4111Spyglass/SatNOGS/SatNOGS_Encoder/satnogs-rotator-controller-encoder-bom.xlsx

Sheet: Encoder
Part | Qty To Buy | Qty In project | Sold in Packs of | Unit of Measure | Distributor | Ref | Distributor Ref | Project Section | Price | Cost to Project | Amazon |  |  | McMaster |  |  | AliExpress
Electronic Components, Encoder | 2 | 2 | 1 | PCE | Mouser | C1014-1 |  | Electronics | 3.5 | 7
PCB, Encoder | 5 | 2 | 1 | 5 PCBs | Elecrow | C1014-1 |  | Electronics | 1 | 5
Diametric Magnet NdFeB, Grade N35, D6x2.5mm | 2 | 2 | 1 | PCE | aliexpress | H1050-1 |  | Hardware | 0.2 | 0.4 | https://www.buyneomagnets.com/p/6mm-x-2-5mm-diametrically-magnetized-disc-magnet-neodymium-round-magnets-n35-rare-earth-radial-magnets-100-pack/ | 100 | 15.59
Set Screw M3 L10 DIN 914 | 2 | 2 | 1 | PCE |  | H1090-1 |  | Hardware | 0.2 | 0.4 | rotator
M3 Nut DIN934 | 10 | 10 | 1 | PCE |  | H1070-1 |  | Hardware | 0.03 | 0.3 | rotator
Screw M3L30 DIN965 | 8 | 8 | 1 | PCE |  | H1080-1 |  | Hardware | 0.04 | 0.32 | https://www.amazon.com/uxcell-M3x30mm-Machine-Stainless-Fasteners/dp/B07WCTFG48?pid=89lkzVM&s=industrial | 50 | 8.09
Washer M3 DIN125 | 10 | 10 | 1 | PCE |  | H1070-1 |  | Hardware | 0.03 | 0.3 | rotator
Linear Shaft - D3mm x L50mm cut 2x L25mm, Tolerance: g6 | 1 | 1 | 1 | PCE | aliexpress | H1060-1 |  | Hardware | 1 | 1 | https://www.amazon.com/150mm-Stainless-Industry-Working-Hobbies/dp/B0D5D3XBMK?sp_csd=d2lkZ2V0TmFtZT1zcF9hdGY | 5 | 5.99 | https://www.mcmaster.com/1327K501/ | 1 | 4.2
Deep groove ball bearing 623zz | 4 | 4 | 1 | PCE | ebay | H1040-1 |  | Hardware | 0.2 | 0.8 | https://www.amazon.com/PCS-623ZZ-Ball-Bearings-Applications/dp/B0GH642RYP | 30 | 5.99 |  |  |  | https://www.aliexpress.com/ssr/300000512/BundleDeals2?productIds=1005009361954271%3A12000048960993106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 | 10 | 4.19
Encoder gear 20T, 1.5M, presure angle:20deg, bore 3mm, 3D printed part 0.5mm | 2 | 2 | 1 | PCE |  | C1013-1 |  | Custom Part
Magnet mount | 2 | 2 | 1 | PCE |  | C1012-1 |  | Custom Part
Encoder case lid | 2 | 2 | 1 | PCE |  | C1011-1 |  | Custom Part
Encoder case | 2 | 2 | 1 | PCE |  | C1010-1 |  | Custom Part
 |  |  |  |  |  |  |  |  | Total | 15.52

Sheet: Electronic_Components,_Encoder
Component | Description | Part | References | Value | Footprint | Quantity Per PCB | Datasheet | Mnf. | Price
1 |  | C_Small | C1 | 100n | C_0805_HandSoldering | 1 |  | 08053C104KAT2A | 0.09
2 |  | C_Small | C2 | 1u | C_0805_HandSoldering | 1 |  | CC0805KKX7R7BB105 | 0.085
3 |  | CONN_02X05 | P1 | CONN_02X05 | Pin_Header_Straight_2x05_Pitch2.54mm | 1 |  | Amphenol-861400402YO2LF | 1.18
4 |  | Q_NMOS_GSD | Q1 | Q_NMOS_GSD | SOT-23_Handsoldering | 1 |  | SI2312CDS-T1-GE3 | 0.398
5 |  | R | R1 R2 | 4k7 | R_0805_HandSoldering | 2 |  | CRCW08054K70JNEA | 0.091
6 |  | AS5601-RESCUE-encoder_as5601 | U1 | AS5601 | SOIC-8_3.9x4.9mm_Pitch1.27mm | 1 |  | AS5601-ASOM | 2.78
Component Groups: | 6
Component Count: | 7
Fitted Components: | 7
Num | er of PCBs: | 1
Total components: | 7
Schematic Version:
Schematic Date: | 2018-01-21
BoM Date: | Sun 21 Jan 2018 07:08:43 PM EET
Schematic Source: | /home/azisi/Documents/SatNOGS/satnogs-rotator-controller/satnogs_encoder/encoder_as5601/encoder_as5601.sch
KiCad Version: | Eeschema 4.0.7
