4111Spyglass/SatNOGS/SatNOGS_Rotator/rotator-bom.xlsx

Sheet: DC Motor
Part | Qty To Buy | Qty In project | Sold in Packs of | Unit of Measure | Distributor | Ref | Distributor Ref | Project Section | Price | Cost to Project | Link
Aluminum Tube 6063 OD40 TH1.5 | 2 | 2 | 1 | PCE | Motedis | C1001-1 and C1001-3 | 2287 | Hardware | 0.9 | 1.8 | https://www.motedis.com/shop/Semi-finished-products/Circular-tube-anodized-DIN-6060/Circular-tube-40x15-anodized::1066.html
Shaft Side | 4 | 4 | 1 | PCE |  | C1010-3 |  | Custom Part |  | 0
Shaft Side Bearing Flange | 4 | 4 | 1 | PCE |  | C1011-3 |  | Custom Part |  | 0
Worm Wheel, 30T | 2 | 2 | 1 | PCE |  | C1020-1 |  | Custom Part |  | 0
Shaft Collar ID40 | 2 | 2 | 1 | PCE |  | C1021-1 |  | Custom Part |  | 0
Shaft Washer ID40 OD50 | 2 | 2 | 1 | PCE |  | C1022-1 |  | Custom Part |  | 0
Motor Mount | 2 | 2 | 1 | PCE |  | C1030-1 |  | Custom Part |  | 0
Encoder Gear | 2 | 2 | 1 | PCE |  | C1040-1 |  | Custom Part |  | 0
Homing Pin | 2 | 2 | 1 | PCE |  | C1041-1 |  | Custom Part |  | 0
End-Stop Mount | 2 | 2 | 1 | PCE |  | C1042-1 |  | Custom Part |  | 0
Encoder Mount | 2 | 2 | 1 | PCE |  | C1043-1 |  | Custom Part |  | 0
Aluminum Profil 20x20 B-type slot 6 L100 | 18 | 18 | 1 | PCE | Motedis | C1050-1 | 22206 | Custom Part | 0.3 | 5.4 | https://www.motedis.com/shop/Slot-profiles/Profile-20-B-Type-slot-6/Profile-20x20-B-type-slot-6::1.html
Aluminum Profil 20x20 B-type slot 6 L140 | 8 | 8 | 1 | PCE | Motedis | C1050-5 | 22206 | Custom Part | 0.45 | 3.6 | https://www.motedis.com/shop/Slot-profiles/Profile-20-B-Type-slot-6/Profile-20x20-B-type-slot-6::1.html
Threaded rod M5 DIN975 INOX A2, Worm Gear Shaft | 1 | 1 | 1 | m |  | C1060-1 |  | Hardware | 2.5 | 2.5
Worm Mount | 4 | 4 | 1 | PCE |  | C1061-3 and C1061-4 |  | Custom Part |  | 0
Worm Gear | 2 | 2 | 1 | PCE |  | C1062-1 |  | Custom Part | 10 | 20 | https://www.shapeways.com/
Deep groove ball bearing 625zz | 4 | 4 | 1 | PCE |  | H1011-1 |  | Hardware | 0.6 | 2.4
Deep groove ball bearing 6008zz | 4 | 4 | 1 | PCE |  | H1012-1 |  | Hardware | 4 | 16
Inner bracket B-type Tslot6 | 40 | 40 | 1 | PCE | Motedis | H1020-1 | 099I9006 | Hardware | 0.5 | 20 | https://www.motedis.com/shop/Slot-profile-accessories/Accessories-20-B-Typ-slot-6/Inner-bracket-20-steel-B-Type-slot-6::562.html
T-nut B-type slot 6 M4 | 32 | 32 | 1 | PCE | Motedis | H1021-1 | 096H06410 | Hardware | 0.2 | 6.4 | https://www.motedis.com/shop/Slot-profile-accessories/Accessories-20-B-Typ-slot-6/T-nut-B-type-slot-6-M4::555.html
M5 Nut DIN934 | 4 | 4 | 1 | PCE |  | H1030-1 |  | Hardware | 0.03 | 0.12
M5 Washer DIN125 | 6 | 6 | 1 | PCE |  | H1031-1 |  | Hardware | 0.03 | 0.18
Timing Pulley GT2 36T, bore 5mm, belt wide 6mm | 2 | 2 | 1 | PCE |  | H1040-1 |  | Hardware | 4.2 | 8.4
Timing Belt GT2, Wide 6mm, Length 158mm, Teeth 79 | 2 | 2 | 1 | PCE |  | H1200-1 |  | Hardware | 1.5 | 3
M3 Nut DIN934 | 26 | 26 | 1 | PCE |  | H1070-1 |  | Hardware | 0.03 | 0.78
M4 Nut DIN934 | 24 | 24 | 1 | PCE |  | H1080-1 |  | Hardware | 0.03 | 0.72
Set Screw M3 L10 DIN 914 | 16 | 16 | 1 | PCE |  | H1090-1 |  | Hardware | 0.2 | 3.2
Screw M4 L25 DIN912 | 16 | 16 | 1 | PCE |  | H1100-1 |  | Hardware | 0.05 | 0.8
Screw M4 L20 DIN912 | 8 | 8 | 1 | PCE |  | H1100-3 |  | Hardware | 0.07 | 0.56
Screw M4 L10 DIN912 | 30 | 30 | 1 | PCE |  | H1100-5 |  | Hardware | 0.08 | 2.4
Washer M4 DIN125 | 34 | 34 | 1 | PCE |  | H1110-1 |  | Hardware | 0.03 | 1.02
Screw M3 L10 DIN912 | 8 | 8 | 1 | PCE |  | H1120-1 |  | Hardware | 0.04 | 0.32
Screw M3 L12 DIN912 | 4 | 4 | 1 | PCE |  | H1120-3 |  | Hardware | 0.04 | 0.16
Washer M3 DIN125 | 12 | 12 | 1 | PCE |  | H1130-1 |  | Hardware | 0.03 | 0.36
U Bolts Clamp for 40mm Tube | 4 | 4 | 1 | PCE |  | H1060-1 |  | Hardware | 2 | 8
CAT5e UTP cable | 6 | 6 | 1 | m |  | H1170-5 |  | Electronics | 0.16 | 0.96
End stop switch SS0505 | 2 | 2 | 1 | PCE | HIGHLY | H1050-1 | SS0505A | Electronics | 0.7 | 1.4
Heat-shrinkable, OD 6.4mm for CAT5E cable | 1 | 1 | 1 | m |  | H1160-3 |  | Electronics | 0.3 | 0.3
Heat-shrinkable, OD 4.8mm, for end-stop cables | 1 | 1 | 1 | m |  | H1160-5 |  | Electronics | 0.25 | 0.25
Crimps for Dupont Female 2.54 pitch | 38 | 38 | 1 | PCE | pololu | H1180-1 | 1930 | Electronics | 0.06 | 2.28 | https://www.pololu.com/product/1930
Dupont, Housing Wire Female 4 Pins 2.54mm (2x2P) | 5 | 5 | 1 | PCE | pololu | H1190-1 | 1910 | Electronics | 0.06 | 0.3
Dupont, Housing Wire Female 3 Pins 2.54mm (1x3P) | 6 | 6 | 1 | PCE | pololu | H1190-3 | 1902 | Electronics | 0.04 | 0.24
ABS Filament for FDM 3D-printer | 1 | 1 | 1 | Kg |  | - |  | Hardware | 17 | 17
DC motor adapter | 2 | 2 | 1 | PCE |  | C1070-1 |  | Custom Part |  | 0
DC motor cover part #1 | 2 | 2 | 1 | PCE |  | C1071-1 |  | Custom Part |  | 0
DC motor cover part #2 | 2 | 2 | 1 | PCE |  | C1072-1 |  | Custom Part |  | 0
DC motor, D37mm L54mm, Gear ratio 50:1, 12V 200RPM 1.2Nm | 2 | 2 | 1 | PCE | pololu | H1001-1 | 1104 | Electronics | 25 | 50 | https://www.pololu.com/product/1104
Timing Pulley GT2 20T, bore 6mm, Belt width 6mm | 2 | 2 | 1 | PCE |  | H1041-3 |  | Hardware | 2.6 | 5.2
Screw M3L6 DIN965 | 8 | 8 | 1 | PCE |  | H1140-1 |  | Hardware | 0.04 | 0.32
Capacitor, MLCC - Leaded 0.1uF 50volts X7R 10% 5.0mm L/S | 2 | 2 | 1 | PCE | Mouser | H1150-1 | 75-1C20X7R104K050B | Electronics | 0.15 | 0.3 | https://gr.mouser.com/ProductDetail/Vishay-Sprague/1C20X7R104K050B/
Heat-shrinkable, OD 38.1mm | 1 | 1 | 1 | m |  | H1160-1 |  | Electronics | 1.8 | 1.8
Stranded Cable ~1.5mm^2 (16AWG) – Red | 1 | 1 | 1 | m |  | H1170-1 |  | Electronics | 0.5 | 0.5
Stranded Cable ~1.5mm^2 (16AWG) – Black | 1 | 1 | 1 | m |  | H1170-1 |  | Electronics | 0.5 | 0.5
 |  |  |  |  |  |  |  |  | Total | 188.97

Sheet: Stepper Motor
Part | Qty To Buy | Qty In project | Sold in Packs of | Unit of Measure | Distributor | Ref | Distributor Ref | Project Section | Price | Cost to Project | Link
Aluminum Tube 6063 OD40 TH1.5 | 2 | 2 | 1 | PCE | Motedis | C1001-1 and C1001-3 | 2287 | Hardware | 0.9 | 1.8 | https://www.motedis.com/shop/Semi-finished-products/Circular-tube-anodized-DIN-6060/Circular-tube-40x15-anodized::1066.html
Shaft Side | 4 | 4 | 1 | PCE |  | C1010-3 |  | Custom Part |  | 0
Shaft Side Bearing Flange | 4 | 4 | 1 | PCE |  | C1011-3 |  | Custom Part |  | 0
Worm Wheel, 30T | 2 | 2 | 1 | PCE |  | C1020-1 |  | Custom Part |  | 0
Shaft Collar ID40 | 2 | 2 | 1 | PCE |  | C1021-1 |  | Custom Part |  | 0
Shaft Washer ID40 OD50 | 2 | 2 | 1 | PCE |  | C1022-1 |  | Custom Part |  | 0
Motor Mount | 2 | 2 | 1 | PCE |  | C1030-1 |  | Custom Part |  | 0
Encoder Gear | 2 | 2 | 1 | PCE |  | C1040-1 |  | Custom Part |  | 0
Homing Pin | 2 | 2 | 1 | PCE |  | C1041-1 |  | Custom Part |  | 0
End-Stop Mount | 2 | 2 | 1 | PCE |  | C1042-1 |  | Custom Part |  | 0
Encoder Mount | 2 | 2 | 1 | PCE |  | C1043-1 |  | Custom Part |  | 0
Aluminum Profil 20x20 B-type slot 6 L100 | 18 | 18 | 1 | PCE | Motedis | C1050-1 | 22206 | Custom Part | 0.3 | 5.4 | https://www.motedis.com/shop/Slot-profiles/Profile-20-B-Type-slot-6/Profile-20x20-B-type-slot-6::1.html
Aluminum Profil 20x20 B-type slot 6 L140 | 8 | 8 | 1 | PCE | Motedis | C1050-5 | 22206 | Custom Part | 0.45 | 3.6 | https://www.motedis.com/shop/Slot-profiles/Profile-20-B-Type-slot-6/Profile-20x20-B-type-slot-6::1.html
Threaded rod M5 DIN975 INOX A2, Worm Gear Shaft | 1 | 1 | 1 | m |  | C1060-1 |  | Hardware | 2.5 | 2.5
Worm Mount | 4 | 4 | 1 | PCE |  | C1061-3 and C1061-4 |  | Custom Part |  | 0
Worm Gear | 2 | 2 | 1 | PCE |  | C1062-1 |  | Custom Part | 10 | 20 | https://www.shapeways.com/
Deep groove ball bearing 625zz | 4 | 4 | 1 | PCE |  | H1011-1 |  | Hardware | 0.6 | 2.4
Deep groove ball bearing 6008zz | 4 | 4 | 1 | PCE |  | H1012-1 |  | Hardware | 4 | 16
Inner bracket B-type Tslot6 | 40 | 40 | 1 | PCE | Motedis | H1020-1 | 099I9006 | Hardware | 0.5 | 20 | https://www.motedis.com/shop/Slot-profile-accessories/Accessories-20-B-Typ-slot-6/Inner-bracket-20-steel-B-Type-slot-6::562.html
T-nut B-type slot 6 M4 | 32 | 32 | 1 | PCE | Motedis | H1021-1 | 096H06410 | Hardware | 0.2 | 6.4 | https://www.motedis.com/shop/Slot-profile-accessories/Accessories-20-B-Typ-slot-6/T-nut-B-type-slot-6-M4::555.html
M5 Nut DIN934 | 4 | 4 | 1 | PCE |  | H1030-1 |  | Hardware | 0.03 | 0.12
M5 Washer DIN125 | 6 | 6 | 1 | PCE |  | H1031-1 |  | Hardware | 0.03 | 0.18
Timing Pulley GT2 36T, bore 5mm, belt wide 6mm | 2 | 2 | 1 | PCE |  | H1040-1 |  | Hardware | 4.2 | 8.4
Timing Belt GT2, Wide 6mm, Length 158mm, Teeth 79 | 2 | 2 | 1 | PCE |  | H1200-1 |  | Hardware | 1.5 | 3
M3 Nut DIN934 | 26 | 26 | 1 | PCE |  | H1070-1 |  | Hardware | 0.03 | 0.78
M4 Nut DIN934 | 24 | 24 | 1 | PCE |  | H1080-1 |  | Hardware | 0.03 | 0.72
Set Screw M3 L10 DIN 914 | 16 | 16 | 1 | PCE |  | H1090-1 |  | Hardware | 0.2 | 3.2
Screw M4 L25 DIN912 | 16 | 16 | 1 | PCE |  | H1100-1 |  | Hardware | 0.05 | 0.8
Screw M4 L20 DIN912 | 8 | 8 | 1 | PCE |  | H1100-3 |  | Hardware | 0.07 | 0.56
Screw M4 L10 DIN912 | 30 | 30 | 1 | PCE |  | H1100-5 |  | Hardware | 0.08 | 2.4
Washer M4 DIN125 | 34 | 34 | 1 | PCE |  | H1110-1 |  | Hardware | 0.03 | 1.02
Screw M3 L10 DIN912 | 8 | 8 | 1 | PCE |  | H1120-1 |  | Hardware | 0.04 | 0.32
Screw M3 L12 DIN912 | 4 | 4 | 1 | PCE |  | H1120-3 |  | Hardware | 0.04 | 0.16
Washer M3 DIN125 | 12 | 12 | 1 | PCE |  | H1130-1 |  | Hardware | 0.03 | 0.36
U Bolts Clamp for 40mm Tube | 4 | 4 | 1 | PCE |  | H1060-1 |  | Hardware | 2 | 8
CAT5e UTP cable | 6 | 6 | 1 | m |  | H1170-5 |  | Electronics | 0.16 | 0.96
End stop switch SS0505 | 2 | 2 | 1 | PCE | HIGHLY | H1050-1 | SS0505A | Electronics | 0.7 | 1.4
Heat-shrinkable, OD 6.4mm for CAT5E cable | 1 | 1 | 1 | m |  | H1160-3 |  | Electronics | 0.3 | 0.3
Heat-shrinkable, OD 4.8mm, for end-stop cables | 1 | 1 | 1 | m |  | H1160-5 |  | Electronics | 0.25 | 0.25
Crimps for Dupont Female 2.54 pitch | 38 | 38 | 1 | PCE | pololu | H1180-1 | 1930 | Electronics | 0.06 | 2.28 | https://www.pololu.com/product/1930
Dupont, Housing Wire Female 4 Pins 2.54mm (2x2P) | 5 | 5 | 1 | PCE | pololu | H1190-1 | 1910 | Electronics | 0.06 | 0.3
Dupont, Housing Wire Female 3 Pins 2.54mm (1x3P) | 6 | 6 | 1 | PCE | pololu | H1190-3 | 1902 | Electronics | 0.04 | 0.24
ABS Filament for FDM 3D-printer | 1 | 1 | 1 | Kg |  | - |  | Hardware | 17 | 17
Stepper motor NEMA17, L47mm, 1.8deg step angle, D-shaft 5mm, Max torque 0.48Nm, without cables | 2 | 2 | 1 | PCE | GRobotronics | H1003-1 | 14-00010849 | Hardware | 16 | 32 | https://grobotronics.com/stepper-motor-42byghw804.html
Timing Pulley GT2 20T, bore 5mm, Belt width 6mm | 2 | 2 | 1 | PCE |  | H1041-1 |  | Hardware | 2.6 | 5.2
Cables 4P for Stepper Motor 70cm JST PH 6P-DUPONT | 2 | 2 | 1 | PCE | GRobotronics | H1170-3 | 19-00010760 | Electronics | 1.2 | 2.4 | https://grobotronics.com/wire-4p-for-stepper-motor-70cm-jst-ph-6p-dupont.html
 |  |  |  |  |  |  |  |  | Total | 170.45
