4111Spyglass/SatNOGS/SatNOGS_Rotator/part-number-list.xlsx

Sheet: Hardware
Part Number | Description | Comments | QTY | Checked | In Stock | Amazon | Units | Cost | McMaster | Units | Cost | AliExpress | Units | Cost
H1001-1_dc_motor | DC motor, D37mm L54mm, Gear ratio 50:1 | DC motor D-Shaft | 2
H1003-1_stepper_motor_nema17 | Stepper motor NEMA17 | This stepper comes with D-Shaft and JST PH male connector on body of motor | 2
H1011-1_625zz | Deep groove ball bearing 625zz | Worm gear axis | 4 | x |  | https://www.amazon.com/uxcell-Groove-Bearings-Shielded-Bearing/dp/B0CJFSBRTJ | 15 | 6.29 | https://www.mcmaster.com/6153K15/ | 1 | 11.57 | https://www.aliexpress.us/item/3256808307376732.html?curPageLogUid=nbfa5K8uiVS3 | 10 | 5.54
H1012-1_6008zz | Deep groove ball bearing 6008zz | Worm wheel axis | 4 | x |  | https://www.amazon.com/ACROPIX-Bearings-40x68x15mm-Lubricated-Skateboard/dp/B0DJ8GDG85 | 4 | 14.77
H1020-1_Inner_bracket_btype_tslot6 | Inner bracket B-type Tslot6 |  | 44 | x |  | https://www.amazon.com/gp/product/B0C6JNRMCV?smid=A1QO26FH6S25Z4&th=1 (https://www.amazon.com/30Sets-Inner-Connector-Extrusion-Brackets/dp/B0C19GVBXB) | 24 | 6.99 |  |  |  | https://www.aliexpress.com/ssr/300000512/BundleDeals2?productIds=1005007087913831%3A12000039358031725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 | 20 | 5.39
H1021-1_bType_nut 6_M4 | B-Typ Nut 6/M4 |  | 32 | x |  | https://www.amazon.com/DGZZI-Nickel-Plated-Aluminum-Extrusion-Fastener/dp/B0C5HWS6F8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 | 100 | 6.99 |  |  |  | https://www.aliexpress.us/item/3256807197032414.html?curPageLogUid=qujSwJRj8fUM | 100 | 6.73
H1030-1_nut_M5_din934 | Nut M5 DIN934 | Worm gear axis | 4 | x |  | https://www.amazon.com/Juvielich-100pcs-Stainless-Fasteners-Replacement/dp/B0D1X2YBLJ | 100 | 5.49 | https://www.mcmaster.com/90592A095/ | 100 | 2.89
H1031-1_washer_M5_din125 | Washer M5 DIN125 | Worm gear axis | 6 | x |  | https://www.amazon.com/Washer-Stainless-Steel-Washers-100PCS/dp/B0BGHBH8RM?sp_csd=d2lkZ2V0TmFtZT1zcF9hdGY | 100 | 4.99 | https://www.mcmaster.com/98687A110/ | 100 | 2.75
H1040-1_pulley_gt2_36T | Timing Pulley GT2 36T, bore 5mm, belt width 6mm | Worm gear axis | 2 | x |  | https://www.amazon.com/Yeebyee-Pulleys-Synchronous-Aluminum-Printers/dp/B0F8ZY24R5?nsdOptOutParam=true | 4 | 12.99 |  |  |  | https://www.aliexpress.us/item/3256806064924677.html?curPageLogUid=9SVPr5AjrKA3 | 1 | 2.23
H1041-1_pulley_gt2_20T | Timing Pulley GT2 20T, bore 5mm, belt width 6mm | Stepper motor axis | 2 |  |  | https://www.amazon.com/SHCEEC-Timing-Pulleys-Printer-Aluminum/dp/B0CB13VP52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 | 5 | 6.49 |  |  |  | https://www.aliexpress.us/item/3256806064924677.html?curPageLogUid=9SVPr5AjrKA3 | 1 | 1.43
H1041-3_pulley_gt2_20T | Timing Pulley GT2 20T, bore 6mm, belt width 6mm | DC motor axis | 2
H1050-1_switch_SS0505 | End stop switch SS0505 |  | 2 | x |  | https://www.amazon.com/dp/B07X142VGC?sp_csd=d2lkZ2V0TmFtZT1zcF9ocXBfc2hhcmVk | 10 | 5.99
H1060-1 | U Bolts Clamp | The model not exist in shared file | 4
H1070-1_nut_M3_din934 | Nut M3 DIN934 |  | 26 | x | x | https://www.amazon.com/dp/B0D99ZJ832?ref_=ppx_hzsearch_conn_dt_b_fed_asin_title_2&th=1 | 100 | 5.97 | https://www.mcmaster.com/90592A085/ | 100 | 1.43
H1080-1_nut_M4_din934 | Nut M4 DIN934 |  | 24 | x | x | https://www.amazon.com/dp/B0D99YP7BP?ref_=ppx_hzsearch_conn_dt_b_fed_asin_title_2&th=1 | 200 | 6.58 | https://www.mcmaster.com/90592A090/ | 100 | 2.09
H1090-1_set_screw_M3L10_din914 | Set Screw M3 L10 DIN914 |  | 16 | x |  | https://www.amazon.com/Internal-Socket-Screws-Stainless-Steel/dp/B0CZ6WYF2T?s=industrial | 100 | 5.99 | https://www.mcmaster.com/91390A103/ | 100 | 13.66
H1100-1_screw_M4L25_din912 | Socket head screw M4 L25 DIN912 |  | 16 | x |  | https://www.amazon.com/BNUOK-120pcs-Socket-Threads-Spanner/dp/B0DYSCWBPR?pid=CidL1Pd&s=industrial | 125 | 8,54 | https://www.mcmaster.com/91290A176/ | 50 | 10.41
H1100-3_screw_M4L20_din912 | Socket head screw M4 L20 DIN912 |  | 8 | x |  | https://www.amazon.com/dp/B0DYSQZHC9/ref=dp_iou_view_item?ie=UTF8&th=1 | 120 | 8.09 | https://www.mcmaster.com/91274A121/ | 50 | 6.11
H1100-5_screw_M4L10_din912 | Socket head screw M4 L10 DIN912 |  | 30 | x |  | https://www.amazon.com/dp/B0DYSDQ6TV/ref=dp_iou_view_item?ie=UTF8&th=1 | 120 | 7.19 | https://www.mcmaster.com/91274A117/ | 50 | 5.28
H1110-1_washer_M4_din125 | Washer M4 DIN125 |  | 34 | x | x | https://www.amazon.com/Washer-Stainless-Steel-Washers-100PCS/dp/B0BGH6YLB7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 | 100 | 4.99 | https://www.mcmaster.com/98687A134/ | 100 | 2.97
H1120-1_screw_M3L10_din912 | Socket head screw M3 L10 DIN912 | For motor mount | 8 |  |  | https://www.amazon.com/Moicstiy-Socket-Screws-Machine-Finish/dp/B0D5B61YVS?s=industrial (https://www.amazon.com/BNUOK-180pcs-Socket-Threads-Spanner/dp/B0DJQGKM9L?pid=r94gVAq&s=industrial) | 100 | 4.49 | https://www.mcmaster.com/91274A105/ | 50 | 5.43
H1120-3_screw_M3L12_din912 | Socket head screw M3 L12 DIN912 | For end-stop | 4 | x |  | https://www.amazon.com/Moicstiy-Socket-Screws-Machine-Finish/dp/B0D5B4SL18?s=industrial (https://www.amazon.com/BNUOK-180pcs-Socket-Threads-Spanner/dp/B0DJQGKM9L?pid=r94gVAq&s=industrial) | 100 | 4.49 | https://www.mcmaster.com/91274A106/ | 50 | 5.42
H1130-1_washer_M3_din125 | Washer M3 DIN125 |  | 12 | x | x | https://www.amazon.com/LIZIFEQZ-100Pcs-Stainless-Washers-Screws/dp/B0GV85XBNG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 | 100 | 4.49 | https://www.mcmaster.com/98687A133/ | 100 | 1.83
H1140-1_screw_M3L6_din965 | Phillips Flat Head Screw M3 L6 DIN965 | For DC motor flange | 8
H1150-1 | MLCC - Leaded 0.1uF 50volts X7R 10% 5.0mm L/S, for DC motors | mouser, model not exist in shared file (http://gr.mouser.com/ProductDetail/Vishay-Sprague/1C20X7R104K050B/) | 2
H1160-1 | Heat-shrinkable, OD 38.1mm, for DC motor wheather shielding | The part is assembled with C1071-1 and C1072-1 (per 1m), model not exist in shared file | 1
H1160-3 | Heat-shrinkable, OD 6.4mm for CAT5E cable | Per 1m, model not exist in shared file | 1
H1160-5 | Heat-shrinkable, OD 4.8mm, for cables, end stop | Per 1m, model not exist in shared file | 1
H1170-1 | Cables for DC motors, ~1.5mm^2 (16AWG) | Per 1m Black and per 1m Red, model not exist in shared file | 2
H1170-3 | Cables 4P for Stepper Motor 70cm (JST PH 6P-DUPONT) | The model not exist in shared file | 2
H1170-5 | CAT5e UTP cable for endstop, encoder, sensors and rotator cable | Per 1m, model not exist in shared file | 6
H1180-1 | Crimps for Dupont Female, 2.54mm pitch | The model not exist in shared file | 38
H1190-1 | Dupont, Housing Wire Female 4 Pins 2.54mm (2x2P) | The model not exist in shared file | 5
H1190-3 | Dupont, Housing Wire Female 3 Pins 2.54mm (1x3P) | The model not exist in shared file | 6
H1200-1 | Timing Belt GT2, Wide 6mm, Length 158mm, Teeth 79 | The model not exist in shared file | 1 |  |  | https://www.amazon.com/MECCANIXITY-Timing-Printing-Closed-Rubber/dp/B0FRDQ7K8F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 | 5 | 7.19 |  |  |  | https://www.aliexpress.us/item/3256807338029262.html?curPageLogUid=nvgNUC7FGfGE | 1 | 1.51
H1210-1 | Phillips Rounded Head Screws for Sheet Metal, M3,5 X 6,5 | The model not exist in shared file | 12
H1220-1 | Slotted pin DIN1481, OD4 Χ L60, 0.14E PCE
C1001-1_symmetric_tube | Aluminium tube OD40mm TH1.5mm L240mm |  |  |  |  | https://www.amazon.com/dp/B0C6QT439J?niid=nl_cl_lst_a_2_1&nrid=VE7B784SGHV6MM5EAPV9 | 2*300 | 12.89
C1001-3_asymmetric_tube | Aluminium tube OD40mm TH1.5mm L320mm |  |  |  |  | https://www.amazon.com/dp/B0F9D8VPC9?niid=nl_cl_lst_a_1_2&nrid=VE7B784SGHV6MM5EAPV9 | 400mm | 17.89 |  |  |  |  |  |  | https://www.harfington.com/products/p-1465918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 | 400 | 14.34

Sheet: Parts
Part Number | Description | Comments | QTY | Check | Sheet
C1001-1_symmetric_tube | Aluminium tube OD40mm TH1.5mm L240mm | Drawing: convert to 1.5"? | 1 | x | A1030
C1001-3_asymmetric_tube | Aluminium tube OD40mm TH1.5mm L320mm | Drawing: convert to 1.5"? | 1
C1010-1_shaft_side | Shaft deep groove ball bearing 6008zz mount | Layer height 0.4mm | 4
C1010-3 | Updated version of shaft side | Layer height 0.4mm | 4 | x | A1031-1 | A1032-1
C1011-1_shaft_bearing | Shaft deep groove ball bearing 6008zz mount | Layer height 0.4mm | 4 | x | A1031-1
C1011-3 | Updated version of shaft side | Layer height 0.4mm | 4 | x | A1032-1
C1020-1_shaft_gear | Worm wheel gear, 30T | Layer height 0.4mm | 2 | x | A1030
C1021-1_shaft_collar | Worm wheel mount | Layer height 0.4mm, metric/imperial option | 2 | x | A1020-1
C1022-1_shaft_spacer | Spacer or washer for shaft | Layer height 0.4mm, metric/imperial option | 2
C1022-3 | Updated version of shaft washer | Layer height 0.4mm or laser cuted | 2 | x | A1030
C1030-1_motor_mount | Motor mount | Layer height 0.4mm | 2 | x | A1070-1
C1040-1_encoder_gear | Encoder gear, slot to mount homing pin | Layer height 0.4mm, metric/imperial option | 2 | x | A1033-1
C1041-1_homing_pin | Homing pin | Layer height 0.4mm, metric/imperial option | 2 | x | A1033-1
C1042-1_endstop_mount | End stop mount | Layer height 0.4mm | 2 | x | A1032-1
C1043-1_encoder_mount | Encoder mount | Layer height 0.4mm | 2 | x | A1032-1
C1050-1_tslot6_100 | Aluprofil 20x20 B-Typ Nut 6 L100 | Drawing | 18 | x | A1001-3
~~C1050-3_tslot6_160~~ | ~~Aluprofil 20x20 B-Typ Nut 6 L160~~ | ~~-~~ | ~~8~~
C1050-5 | Updated version of C1050-3, L140 | - | 8 | x | A1001-3 | A1040
C1060-1_worm_shaft | Threaded rod M5 L100 for worm gear shaft | Drawing | 2 | x | A1010-1
C1061-1_worm_mount | Worm mount | Layer height 0.4mm | 2
C1061-2_worm_mount | worm mount mirror part | Layer height 0.4mm | 2
C1061-3 | Updated version of C1061-1 | Layer height 0.4mm | 2 | x | A1011
C1061-4 | Updated version of C1061-2 | Layer height 0.4mm | 2 | x | A1011
C1062-1_worm_gear | Worm gear, is laser sintering part with nylon plastic | Laser sintering part, shapeways | 2 | x | A1010-1
C1070-1_dc_motor_adapter | DC motor flange to mount in common stepper motor mount | Layer height 0.4mm | 2
C1071-1_dc_motor_cover | DC motor cover, part 1 | Layer height 0.4mm | 2
C1072-1_dc_motor_cover | DC motor cover, part 2 | Layer height 0.4mm | 2
C1080-1_cover_bottom | Cover box, bottom part | Sheet metal working, Drawing | 1
C1081-1_cover_top | Cover box, top part | Sheet metal working, Drawing | 1
C1082-1_cover_side | Cover box, side part | Sheet metal working, Drawing | 1
C1082-3_cover_side | Cover box, side part | Sheet metal working, Drawing | 1
C1082-5 | Cover box, side part, new revision of C1082-1 and -3 | Sheet metal working, Drawing | 2
C1083-1_shaft_seal | Shaft seal | Layer height 0.4mm, metric/imperial option | 3

Sheet: Assemblies
Part Number | Description | Comments | QTY | Checked | Sheet
A1001-1_frame | Frame chassis sub assembly | Drawing | - | x | A1001-3 | A1030
A1001-3_frame | Frame chassis sub assembly | Drawing | 2 | x | A1040
A1010-1_worm_gear | Worm gear assembly | Drawing | 2 | x | A1040
A1011-1_worm_mount | Worm mount assembly | Drawing | 2 | x | A1001-3
A1011-2_worm_mount | Worm mount assembly, mirror | - | 2
A1020-1_shaft_collar | Shaft collar assembly for worm wheel | Drawing | 2 | x | A1030
A1030-1_rotator_axis | Rotator axis assembly without frame, symmetric | Drawing | 2 | x | A1040
A1030-3_rotator_axis | Rotator axis assembly without frame, asymmetric | - | 2
A1031-1_bearing_side | Bearing side assembly without end-stop and encoder mounts | Drawing | 2 | x | A1030
A1032-1_bearing_side | Bearing side assembly with end-stop and encoder mounts | Drawing | 2 | x | A1030
A1033-1_encoder_gear | Encoder gear assembly | Drawing | 2 | x | A1030
A1040-1_symmetric_module | Rotator axis module with frame, symmetric | Drawing | 2 | x | A1050-1
A1040-3_assymetric_module | Rotator axis module with frame, asymmetric | - | 2 | x | A1050-1
A1050-1_az_el_rotator | Alt-Az antenna rotator | Drawing | 1
A1060-1_dc_motor | DC motor assembly | Drawing | 2 | x | A1030
A1070-1_motor_mount | Motor Mount assembly | Drawing | 2
