4111Spyglass/SatNOGS/SatNOGS_Controller/lsf-kicad-lib-master/3d/MQ_Sensors/MQ-131.step

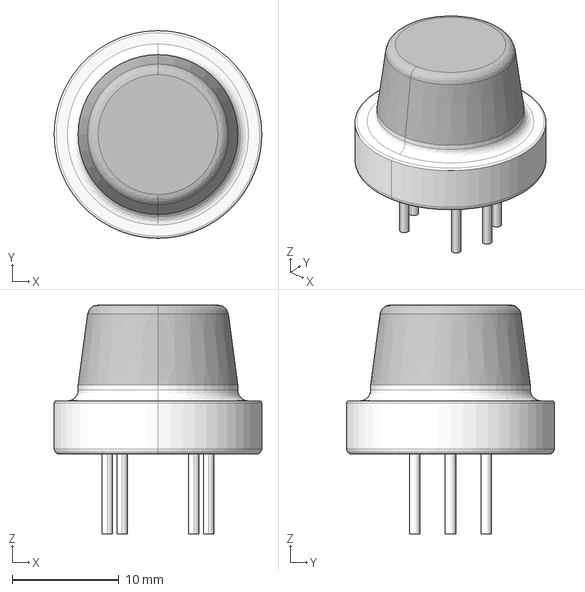
[picture p1: CAD file, 2026-06-04]
SatNOGS_Controller/lsf-kicad-lib-master/3d/MQ_Sensors/MQ-131.step
19.5 x 19.5 x 21.5 mm
