4111Spyglass/SatNOGS/SatNOGS_Controller/lsf-kicad-lib-master/3d_sources/D2F-L2-A1.FCStd

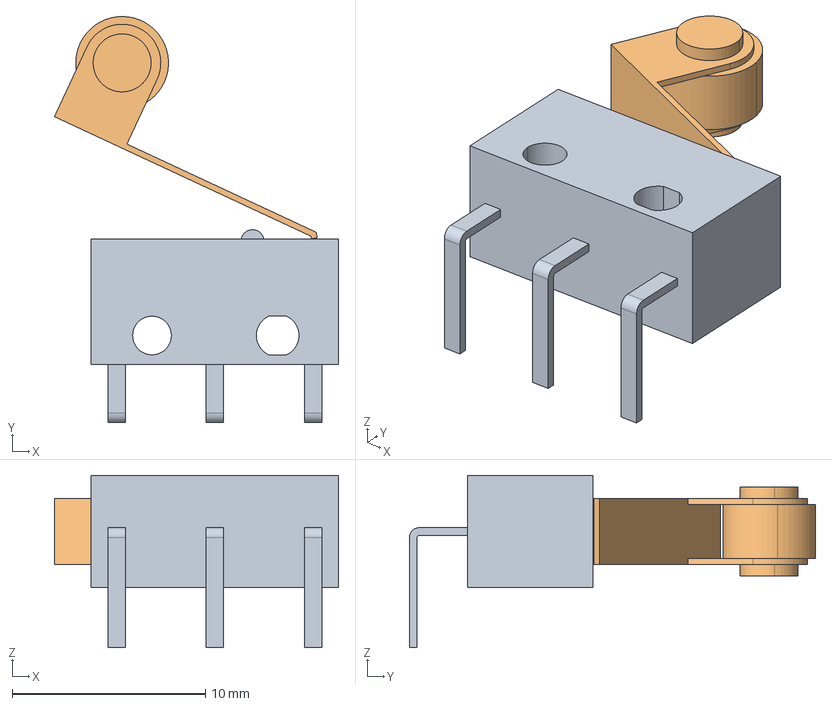
[picture p2: CAD file, 2026-06-04]
SatNOGS_Controller/lsf-kicad-lib-master/3d_sources/D2F-L2-A1.FCStd
14.7 x 21.0 x 8.90 mm
D2F_L2_A1_BASE
D2F_L2_A1_ACTUATOR
