4111Spyglass/SatNOGS/SatNOGS_Controller/SatNOGS_Controller.step

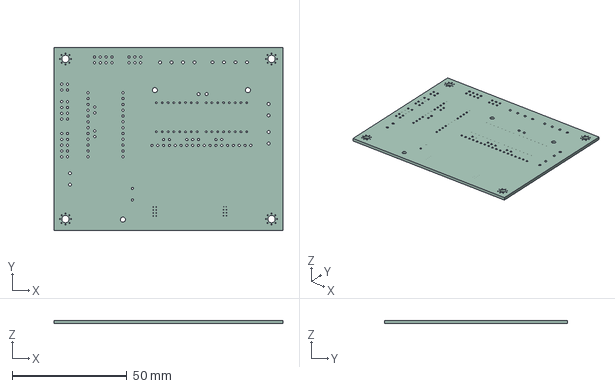
[picture p3: CAD file, 2026-06-04]
SatNOGS_Controller/SatNOGS_Controller.step
100.0 x 80.0 x 1.51 mm
