4111Spyglass/SatNOGS/SatNOGS_Controller/step/drv8825-stepper-motor-driver-carrier-high-current.step

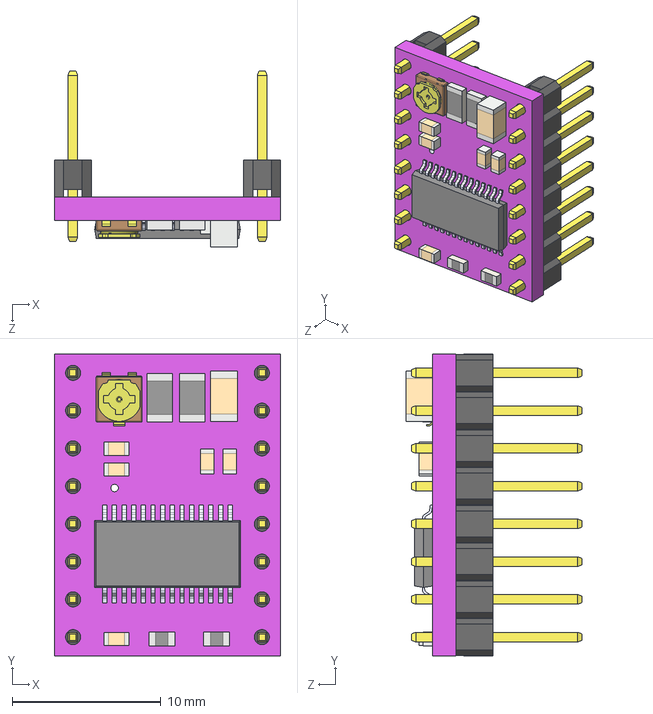
[picture p4: CAD file, 2026-06-04]
SatNOGS_Controller/step/drv8825-stepper-motor-driver-carrier-high-current.step
15.2 x 20.3 x 11.9 mm
