4111Spyglass/SatNOGS/SatNOGS_Encoder/encoder_parts/C1012-1_magnet_mount.fcstd

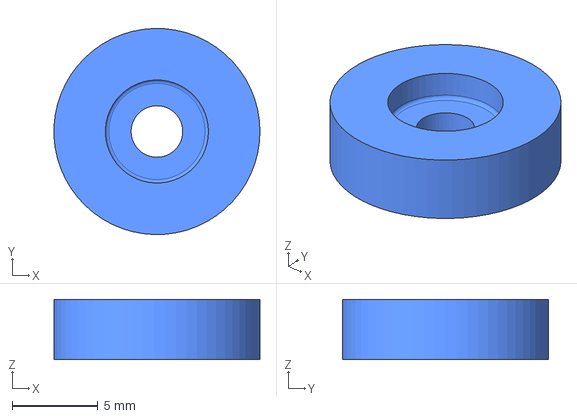
[picture p5: CAD file, 2026-06-04]
SatNOGS_Encoder/encoder_parts/C1012-1_magnet_mount.fcstd
12.0 x 12.0 x 3.50 mm
