4111Spyglass/SatNOGS/SatNOGS_Rotator/rotator_parts/C1070-1_dc_motor_adapter.fcstd

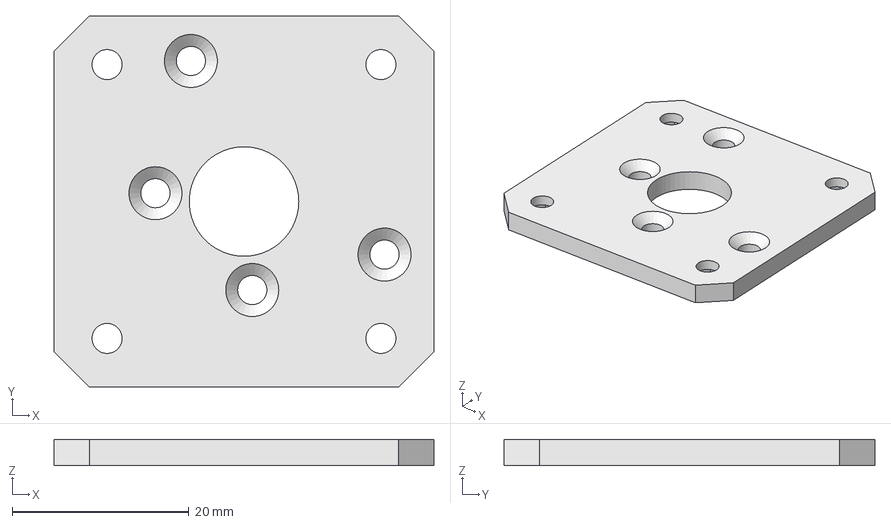
[picture p6: CAD file, 2026-06-04]
SatNOGS_Rotator/rotator_parts/C1070-1_dc_motor_adapter.fcstd
43.0 x 42.0 x 3.00 mm
