4111Spyglass/SatNOGS/SatNOGS_Encoder/encoder_parts/C1013-1_encoder_gear-Body.3mf

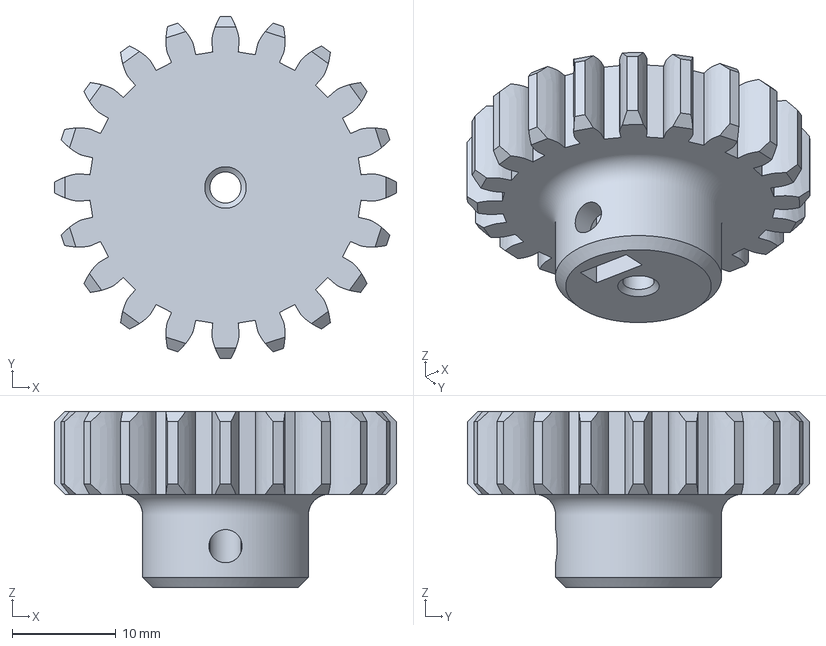
[picture p7: CAD file, 2026-06-04]
SatNOGS_Encoder/encoder_parts/C1013-1_encoder_gear-Body.3mf
33.0 x 33.0 x 17.0 mm
