4111Spyglass/SatNOGS/SatNOGS_Rotator/rotator_parts/C1010-3.fcstd

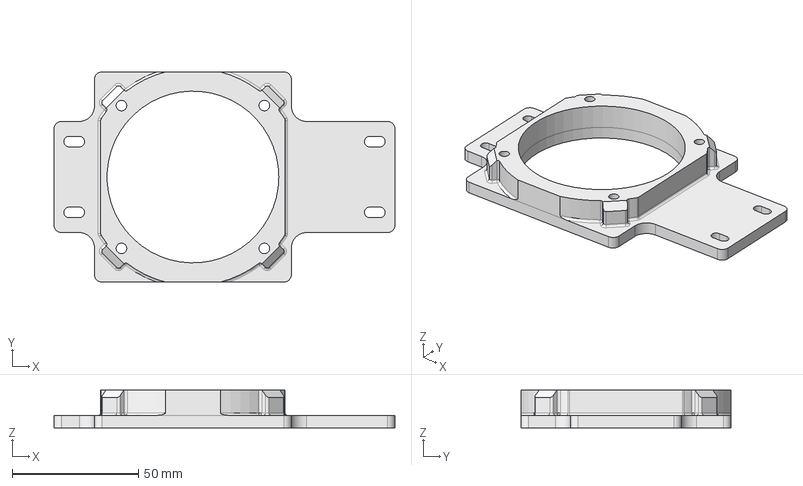
[picture p8: CAD file, 2026-06-04]
SatNOGS_Rotator/rotator_parts/C1010-3.fcstd
135.0 x 83.2 x 15.0 mm
