4111Spyglass/SatNOGS/SatNOGS_Controller/lsf-kicad-lib-master/3d_sources/SMC_Amphenol_152119_Vertical.FCStd

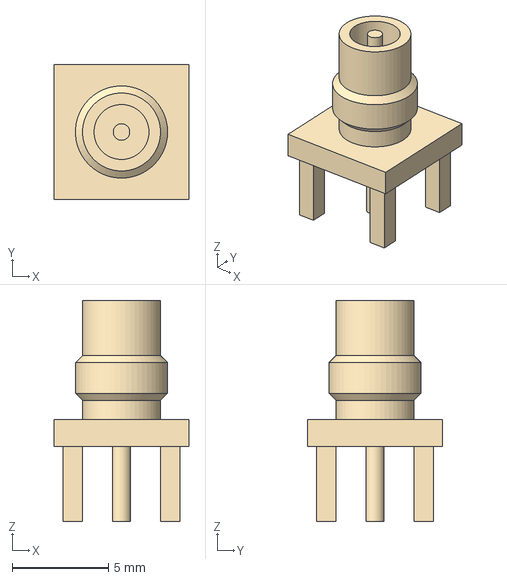
[picture p9: CAD file, 2026-06-04]
SatNOGS_Controller/lsf-kicad-lib-master/3d_sources/SMC_Amphenol_152119_Vertical.FCStd
7.00 x 7.00 x 11.5 mm
