4111Spyglass/SatNOGS/SatNOGS_Encoder/encoder_parts/C1011-1_encoder_case.fcstd

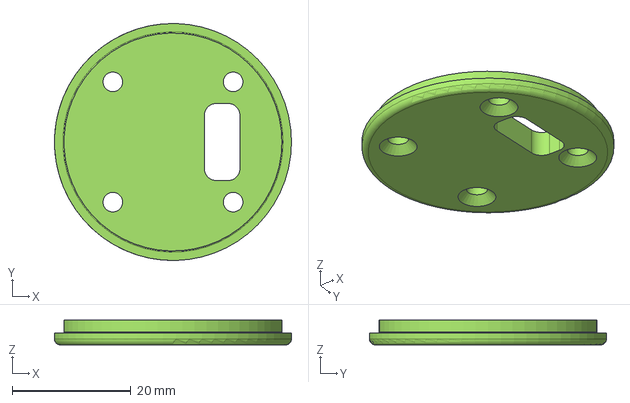
[picture p10: CAD file, 2026-06-04]
SatNOGS_Encoder/encoder_parts/C1011-1_encoder_case.fcstd
40.0 x 40.0 x 4.20 mm
