4111Spyglass/SatNOGS/SatNOGS_Rotator/rotator_parts/C1042-1_endstop_mount.fcstd

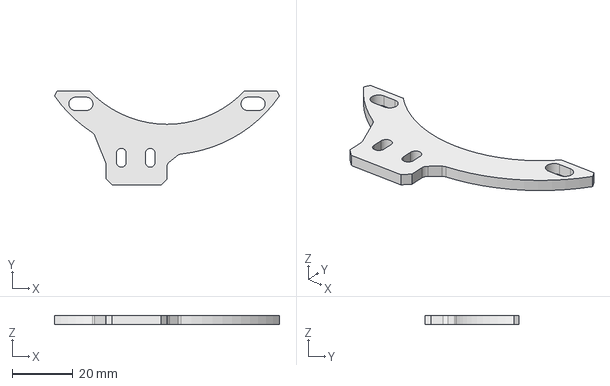
[picture p11: CAD file, 2026-06-04]
SatNOGS_Rotator/rotator_parts/C1042-1_endstop_mount.fcstd
73.9 x 31.0 x 3.00 mm
