4111Spyglass/SatNOGS/SatNOGS_Encoder/encoder_parts/C1010-1_encoder_case.fcstd

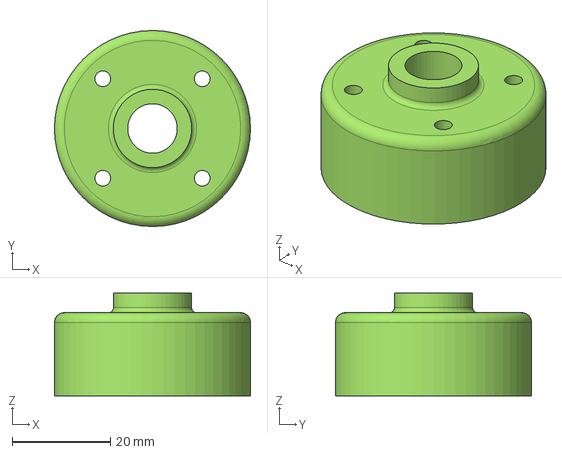
[picture p12: CAD file, 2026-06-04]
SatNOGS_Encoder/encoder_parts/C1010-1_encoder_case.fcstd
40.0 x 40.0 x 21.0 mm
