4111Spyglass/SatNOGS/SatNOGS_Rotator/rotator_parts/C1050-1_tslot6_100.fcstd

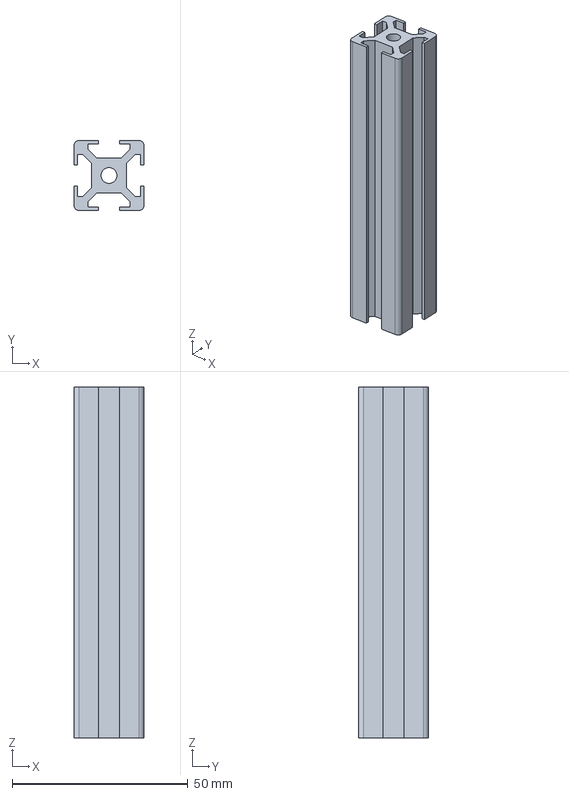
[picture p13: CAD file, 2026-06-04]
SatNOGS_Rotator/rotator_parts/C1050-1_tslot6_100.fcstd
20.0 x 20.0 x 100.0 mm
