4111Spyglass/SatNOGS/SatNOGS_Controller/lsf-kicad-lib-master/3d_sources/MQ-7.FCStd

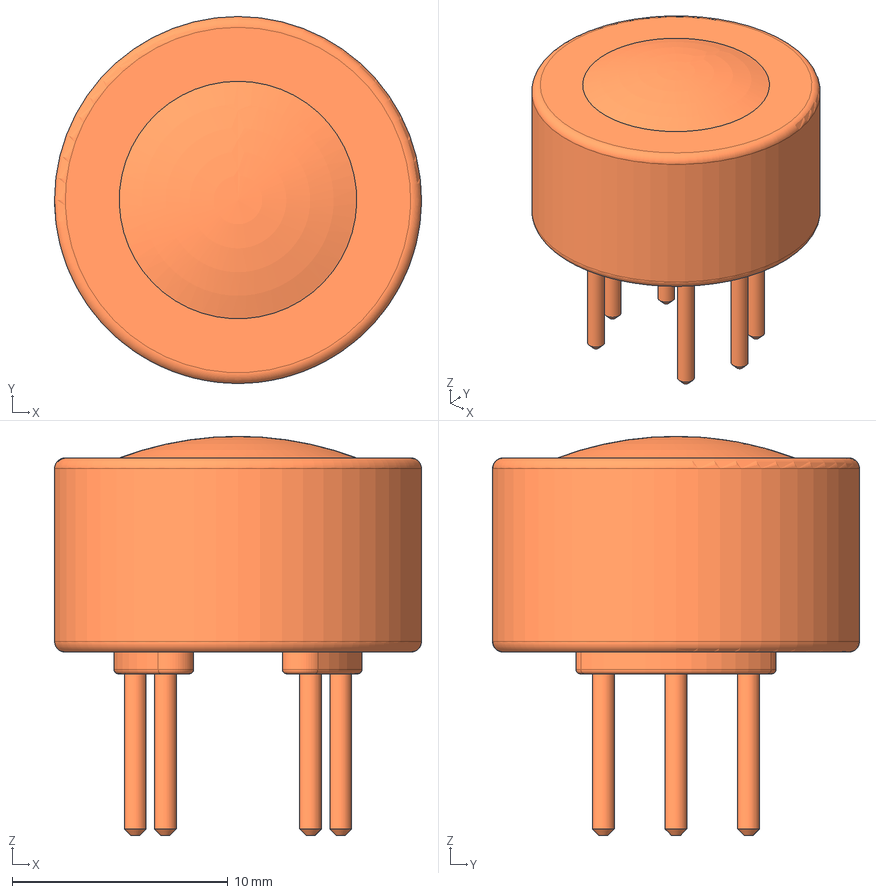
[picture p14: CAD file, 2026-06-04]
SatNOGS_Controller/lsf-kicad-lib-master/3d_sources/MQ-7.FCStd
17.0 x 17.0 x 18.5 mm
