4111Spyglass/SatNOGS/SatNOGS_Encoder/encoder_parts/A1010-1_as5601_encoder.fcstd

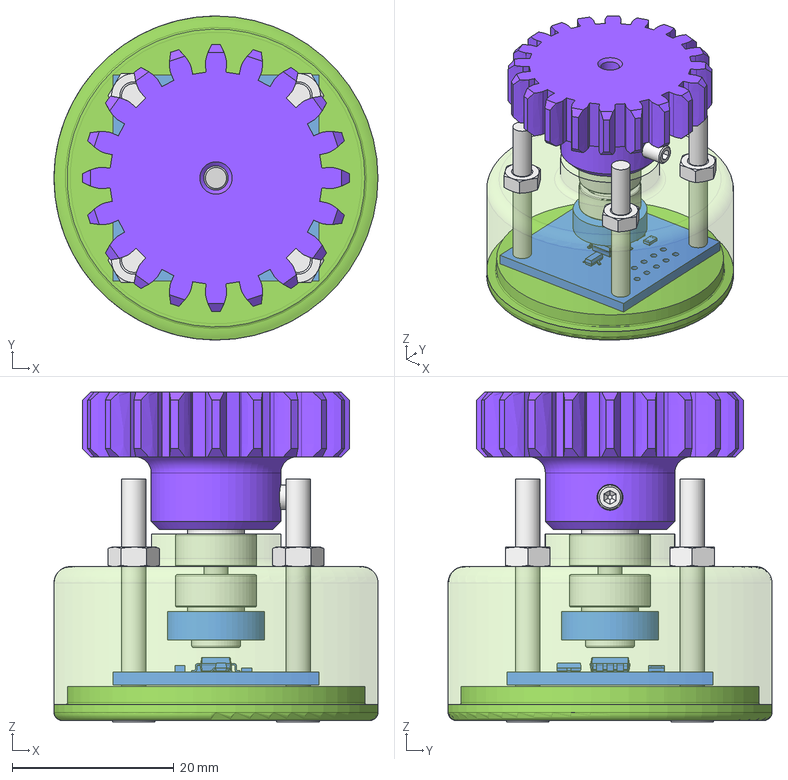
[picture p15: CAD file, 2026-06-04]
SatNOGS_Encoder/encoder_parts/A1010-1_as5601_encoder.fcstd
40.0 x 40.0 x 40.7 mm
H1010_623zz_01
H1010_623zz_02
H1090_washer_M3_din125_01
C1093_magnet_mount_01
H1070_diametric_magnet_01
H1110_encoder_shaft_01
H1090_washer_M3_din125_02
C1091_encoder_case_01
C1096_encoder_gear_01
H1020_1_nut_M3_din934_01
H1080_1_screw_M3L30_din965_01
H1080_1_screw_M3L30_din965_02
H1080_1_screw_M3L30_din965_03
H1080_1_screw_M3L30_din965_04
H1020_1_nut_M3_din934_01001
H1020_1_nut_M3_din934_02
H1020_1_nut_M3_din934_03
H1020_1_nut_M3_din934_04
C1014_1_pcb_as5601_01
C1010_1_encoder_case_01
H1090_1_set_screw_M3L10_din914_01
