4111Spyglass/SatNOGS/SatNOGS_Rotator/rotator_parts/C1082-3_cover_side.fcstd

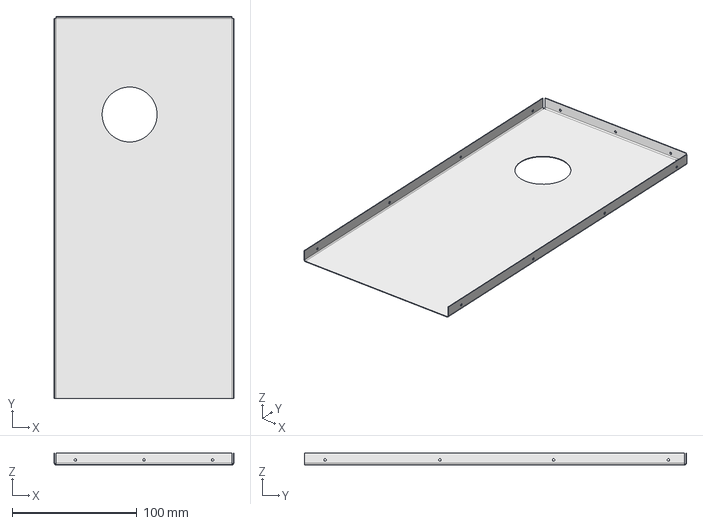
[picture p16: CAD file, 2026-06-04]
SatNOGS_Rotator/rotator_parts/C1082-3_cover_side.fcstd
144.0 x 306.0 x 9.50 mm
