4111Spyglass/SatNOGS/SatNOGS_Controller/lsf-kicad-lib-master/3d_sources/SM141K04LV.FCStd

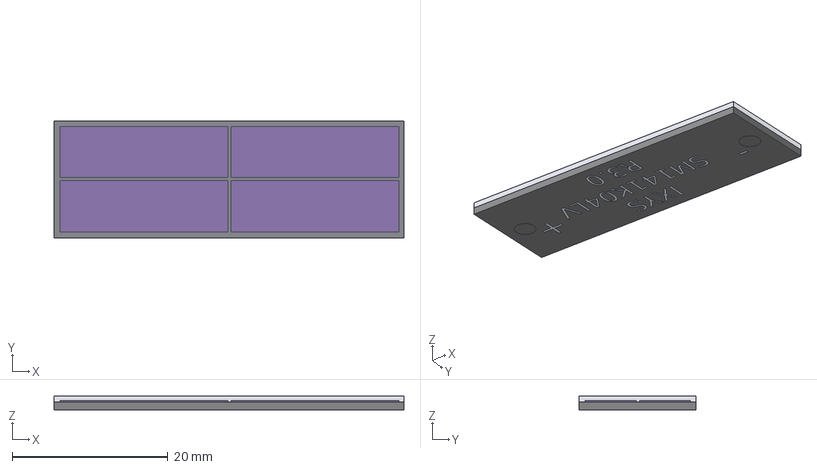
[picture p17: CAD file, 2026-06-04]
SatNOGS_Controller/lsf-kicad-lib-master/3d_sources/SM141K04LV.FCStd
45.0 x 15.0 x 1.81 mm
SM141K04LV
cell1
cell2
cell3
cell4
IXYS
SM141K04LV001
R3.0
+
