4111Spyglass/SatNOGS/SatNOGS_Encoder/encoder_parts/C1014-1_pcb_as5601.fcstd

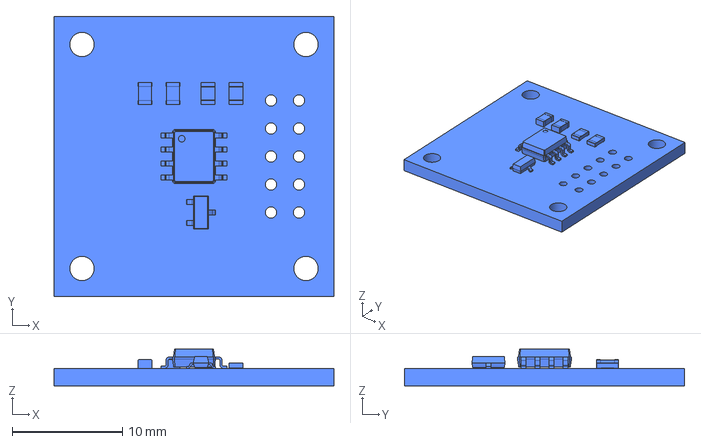
[picture p18: CAD file, 2026-06-04]
SatNOGS_Encoder/encoder_parts/C1014-1_pcb_as5601.fcstd
25.4 x 25.4 x 3.35 mm
