4111Spyglass/SatNOGS/SatNOGS_Rotator/rotator_parts/C1022-3.fcstd

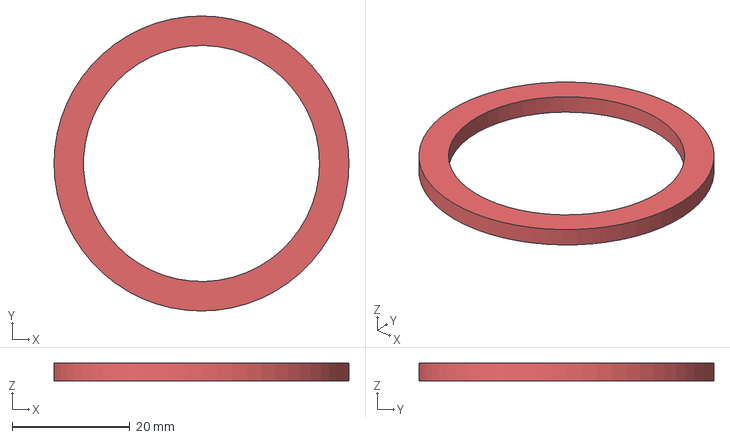
[picture p19: CAD file, 2026-06-04]
SatNOGS_Rotator/rotator_parts/C1022-3.fcstd
50.0 x 50.0 x 3.00 mm
