4111Spyglass/SatNOGS/SatNOGS_Controller/lsf-kicad-lib-master/3d_sources/SW_SPST_SPVN110107.FCStd

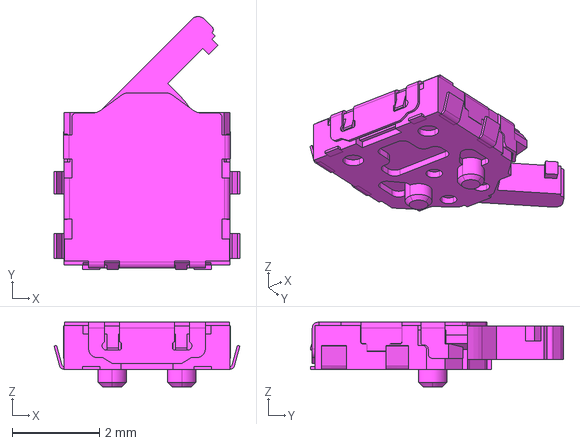
[picture p20: CAD file, 2026-06-04]
SatNOGS_Controller/lsf-kicad-lib-master/3d_sources/SW_SPST_SPVN110107.FCStd
4.26 x 5.80 x 1.48 mm
