4111Spyglass/SatNOGS/SatNOGS_Rotator/rotator_parts/C1011-3.fcstd

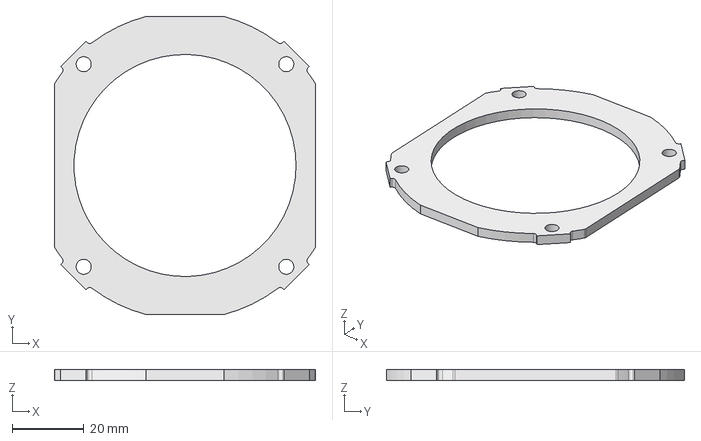
[picture p21: CAD file, 2026-06-04]
SatNOGS_Rotator/rotator_parts/C1011-3.fcstd
73.0 x 83.2 x 3.00 mm
