4111Spyglass/SatNOGS/SatNOGS_Controller/lsf-kicad-lib-master/3d_sources/SATA-3M-5607-5102-SH.FCStd

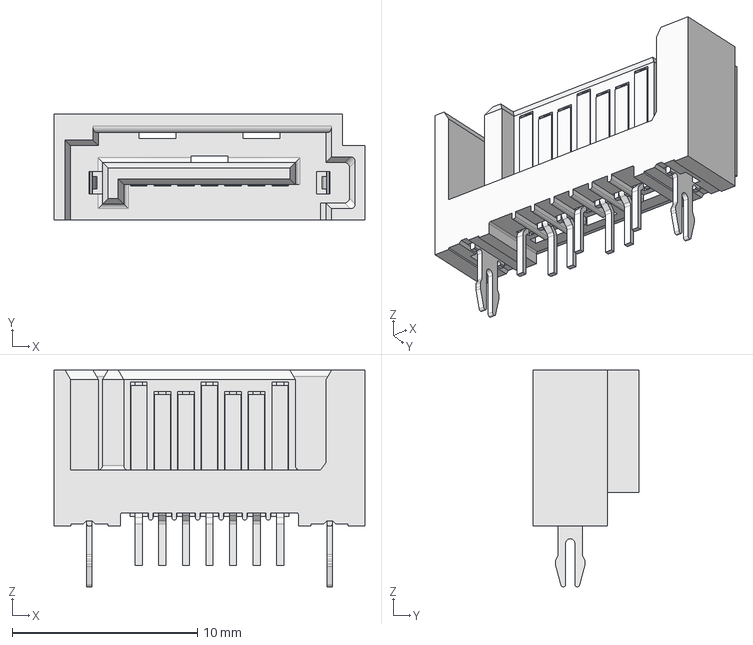
[picture p22: CAD file, 2026-06-04]
SatNOGS_Controller/lsf-kicad-lib-master/3d_sources/SATA-3M-5607-5102-SH.FCStd
16.8 x 5.70 x 11.7 mm
