4111Spyglass/SatNOGS/SatNOGS_Rotator/rotator_parts/C1020-1_shaft_gear.fcstd

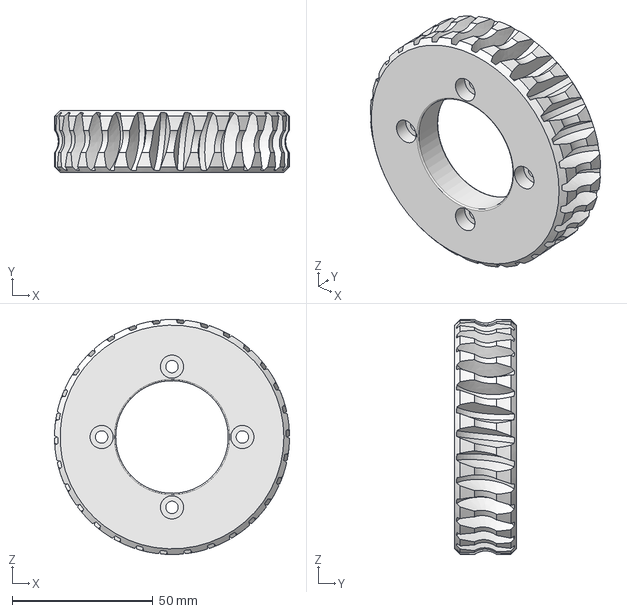
[picture p23: CAD file, 2026-06-04]
SatNOGS_Rotator/rotator_parts/C1020-1_shaft_gear.fcstd
83.5 x 22.0 x 83.5 mm
