4111Spyglass/SatNOGS/SatNOGS_Rotator/rotator_parts/C1001-3_asymmetric_tube.fcstd

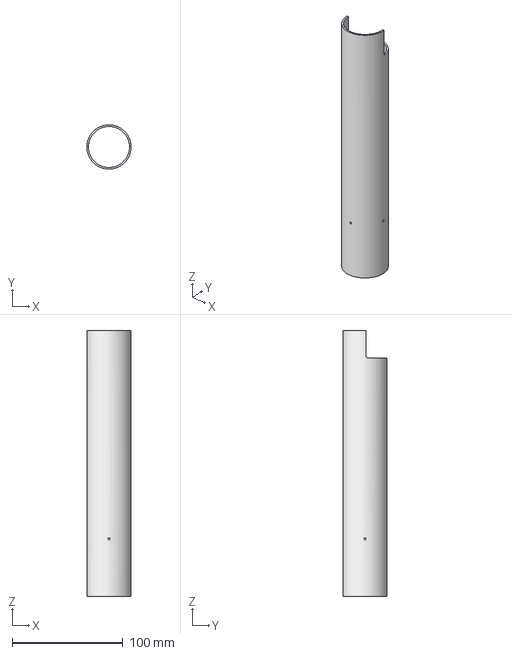
[picture p24: CAD file, 2026-06-04]
SatNOGS_Rotator/rotator_parts/C1001-3_asymmetric_tube.fcstd
40.0 x 40.0 x 240.0 mm
