4111Spyglass/SatNOGS/SatNOGS_Controller/lsf-kicad-lib-master/3d_sources/DF11-10DP-2DS.FCStd

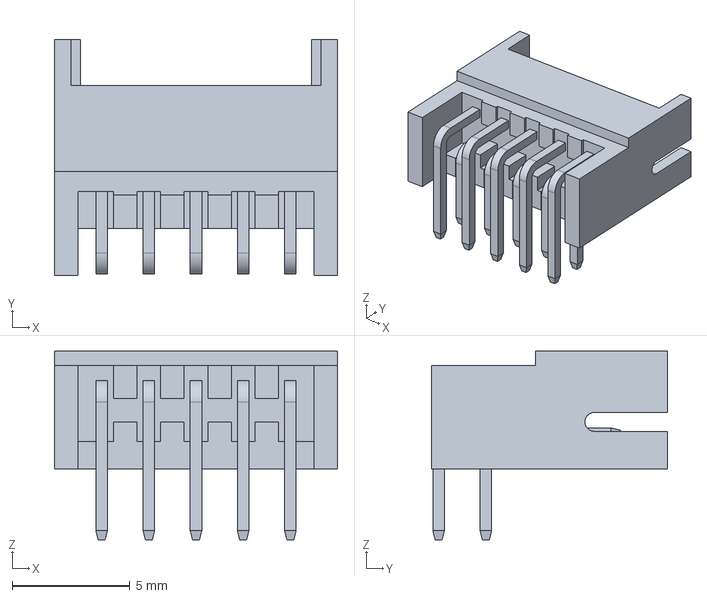
[picture p25: CAD file, 2026-06-04]
SatNOGS_Controller/lsf-kicad-lib-master/3d_sources/DF11-10DP-2DS.FCStd
12.0 x 10.0 x 8.00 mm
