4111Spyglass/SatNOGS/SatNOGS_Rotator/rotator_parts/C1081-1_cover_top.fcstd

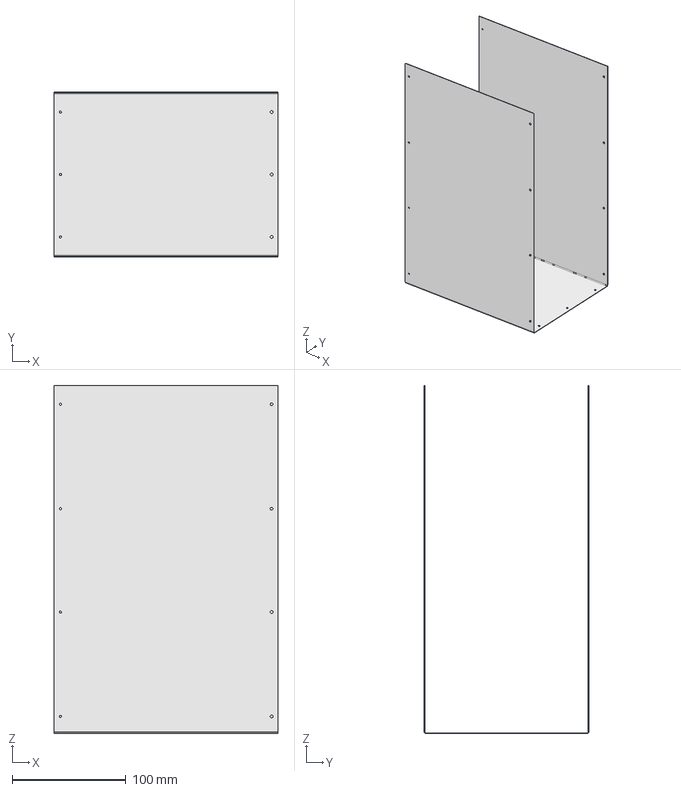
[picture p26: CAD file, 2026-06-04]
SatNOGS_Rotator/rotator_parts/C1081-1_cover_top.fcstd
197.0 x 145.0 x 306.5 mm
