4111Spyglass/SatNOGS/SatNOGS_Controller/lsf-kicad-lib-master/3d_sources/D2F-L.FCStd

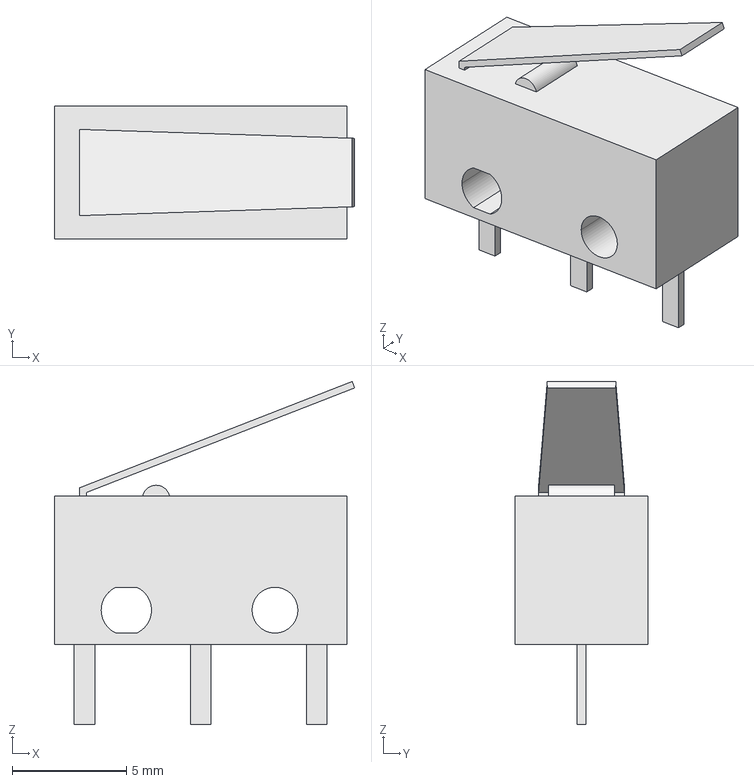
[picture p27: CAD file, 2026-06-04]
SatNOGS_Controller/lsf-kicad-lib-master/3d_sources/D2F-L.FCStd
13.1 x 5.80 x 15.0 mm
