4111Spyglass/SatNOGS/SatNOGS_Rotator/rotator_parts/C1040-1_encoder_gear.3mf

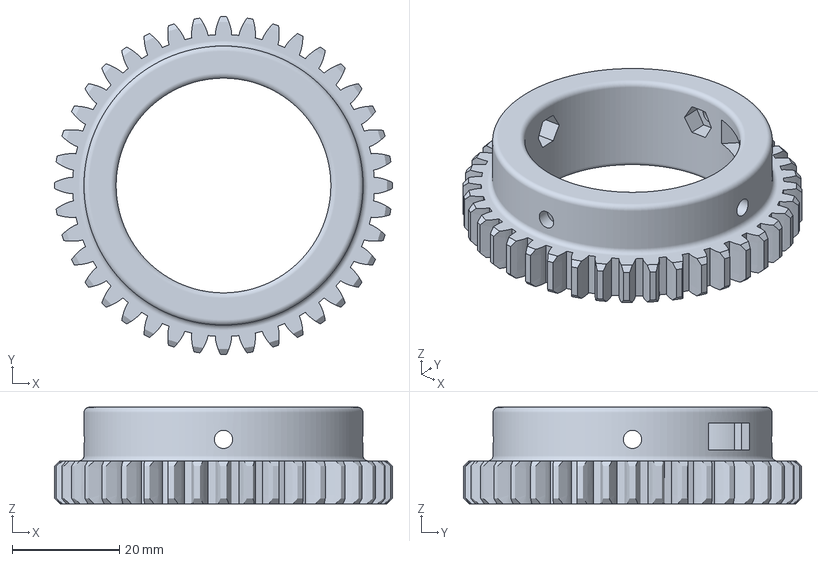
[picture p28: CAD file, 2026-06-04]
SatNOGS_Rotator/rotator_parts/C1040-1_encoder_gear.3mf
63.0 x 63.0 x 18.0 mm
