4111Spyglass/SatNOGS/SatNOGS_Controller/lsf-kicad-lib-master/3d_sources/NP-BX1.FCStd

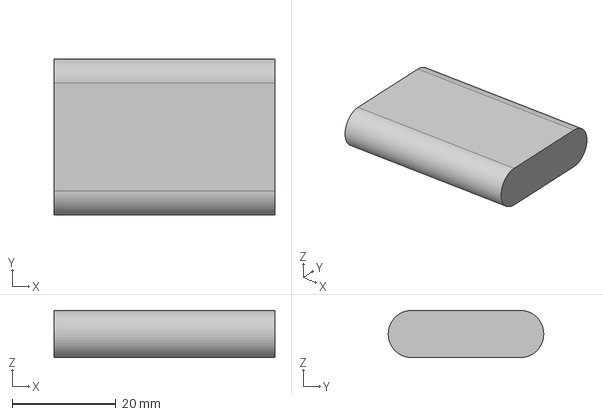
[picture p29: CAD file, 2026-06-04]
SatNOGS_Controller/lsf-kicad-lib-master/3d_sources/NP-BX1.FCStd
42.6 x 30.0 x 9.10 mm
