4111Spyglass/SatNOGS/SatNOGS_Rotator/rotator_parts/C1043-1_encoder_mount.fcstd

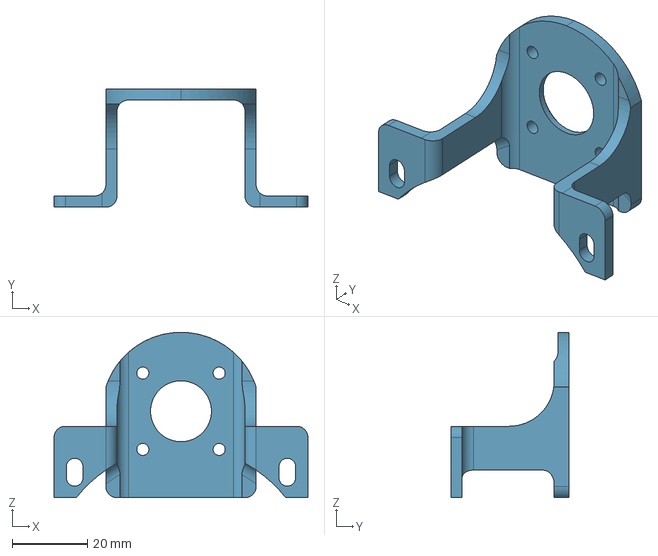
[picture p30: CAD file, 2026-06-04]
SatNOGS_Rotator/rotator_parts/C1043-1_encoder_mount.fcstd
67.6 x 31.5 x 44.0 mm
