4111Spyglass/SatNOGS/SatNOGS_Controller/lsf-kicad-lib-master/3d_sources/KEYSTONE-1502-2.FCStd

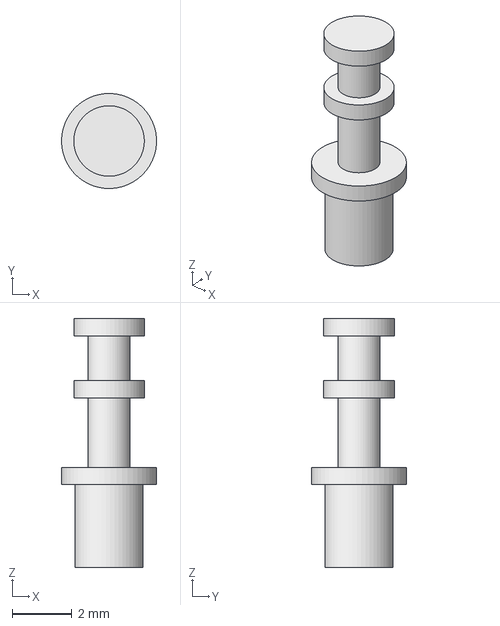
[picture p31: CAD file, 2026-06-04]
SatNOGS_Controller/lsf-kicad-lib-master/3d_sources/KEYSTONE-1502-2.FCStd
3.18 x 3.18 x 8.33 mm
