4111Spyglass/SatNOGS/SatNOGS_Rotator/rotator_parts/C1021-1_shaft_collar.fcstd

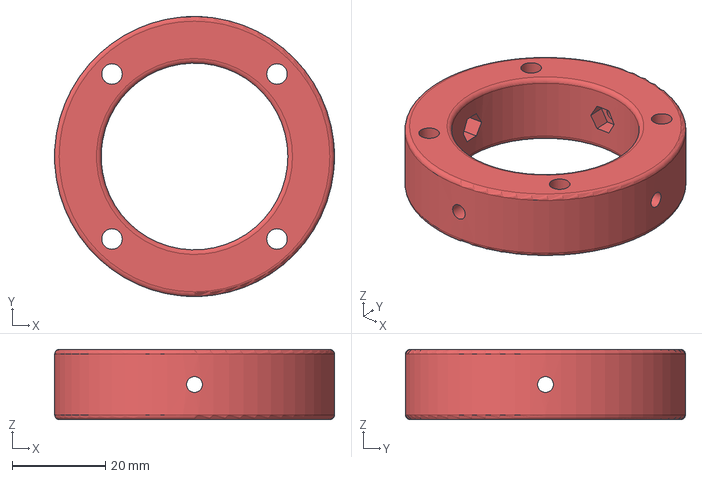
[picture p32: CAD file, 2026-06-04]
SatNOGS_Rotator/rotator_parts/C1021-1_shaft_collar.fcstd
60.0 x 60.0 x 15.0 mm
