4111Spyglass/SatNOGS/SatNOGS_Controller/lsf-kicad-lib-master/3d_sources/Xilinx ZYNQ-7000 SOM.FCStd

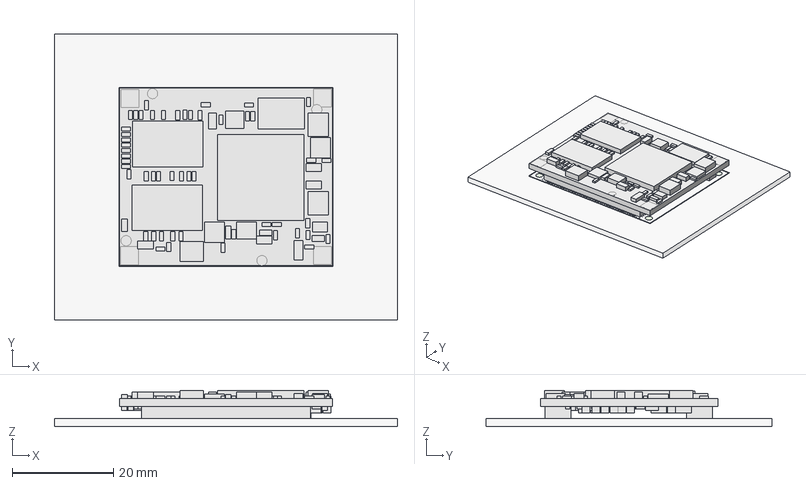
[picture p33: CAD file, 2026-06-04]
SatNOGS_Controller/lsf-kicad-lib-master/3d_sources/Xilinx ZYNQ-7000 SOM.FCStd
67.7 x 56.5 x 7.15 mm
FCrtYd
FFab
FrontSilk
TopPads
PTHs
Pcb
Alinx_ZYNQ-7000_SOM_XC7Z020
