4111Spyglass/SatNOGS/SatNOGS_Rotator/rotator_parts/C1080-1_cover_bottom.fcstd

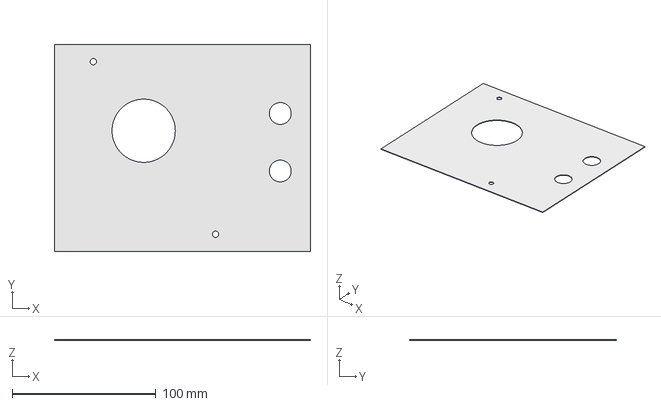
[picture p34: CAD file, 2026-06-04]
SatNOGS_Rotator/rotator_parts/C1080-1_cover_bottom.fcstd
178.0 x 144.0 x 0.5 mm
