4111Spyglass/SatNOGS/SatNOGS_Controller/lsf-kicad-lib-master/3d_sources/KEYSTONE-7698.FCStd

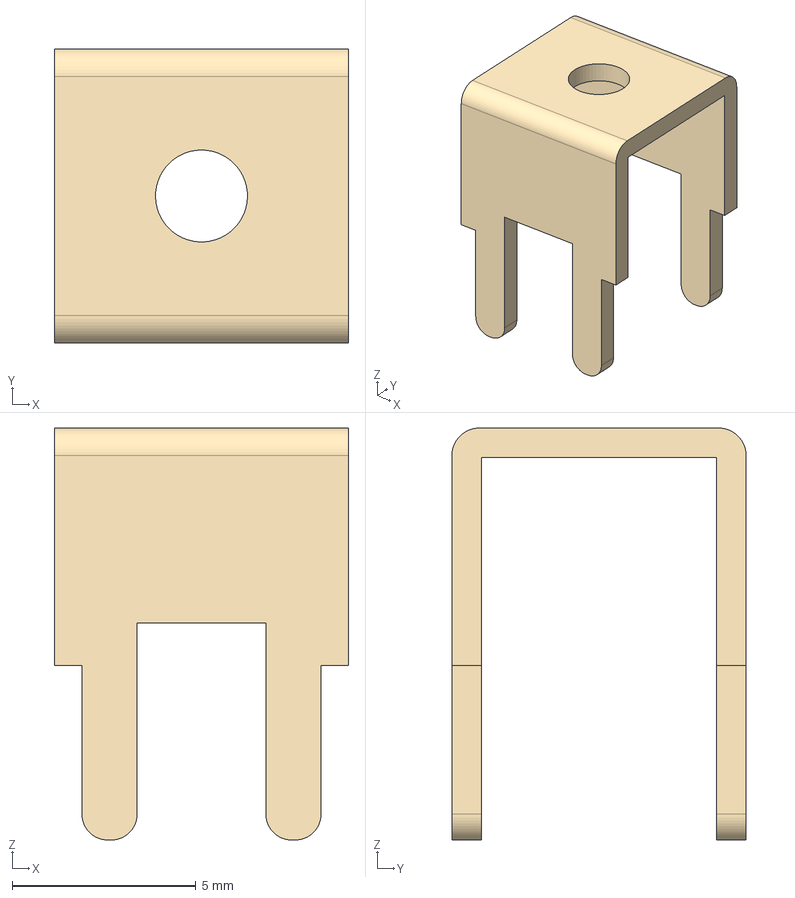
[picture p35: CAD file, 2026-06-04]
SatNOGS_Controller/lsf-kicad-lib-master/3d_sources/KEYSTONE-7698.FCStd
8.00 x 8.00 x 11.2 mm
