4111Spyglass/SatNOGS/SatNOGS_Rotator/rotator_parts/C1041-1_homing_pin.fcstd

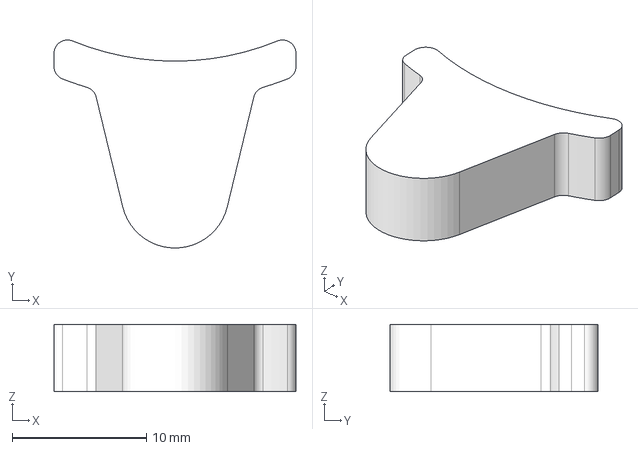
[picture p36: CAD file, 2026-06-04]
SatNOGS_Rotator/rotator_parts/C1041-1_homing_pin.fcstd
18.0 x 15.5 x 5.00 mm
