4111Spyglass/SatNOGS/SatNOGS_Controller/lsf-kicad-lib-master/3d_sources/ATB2012.FCStd

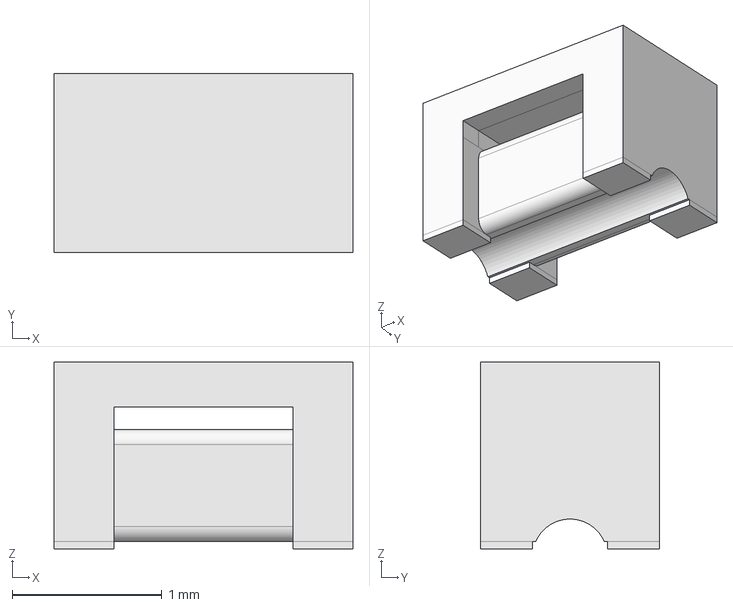
[picture p37: CAD file, 2026-06-04]
SatNOGS_Controller/lsf-kicad-lib-master/3d_sources/ATB2012.FCStd
2.00 x 1.20 x 1.25 mm
