4111Spyglass/SatNOGS/SatNOGS_Rotator/rotator_parts/C1071-1_dc_motor_cover.fcstd

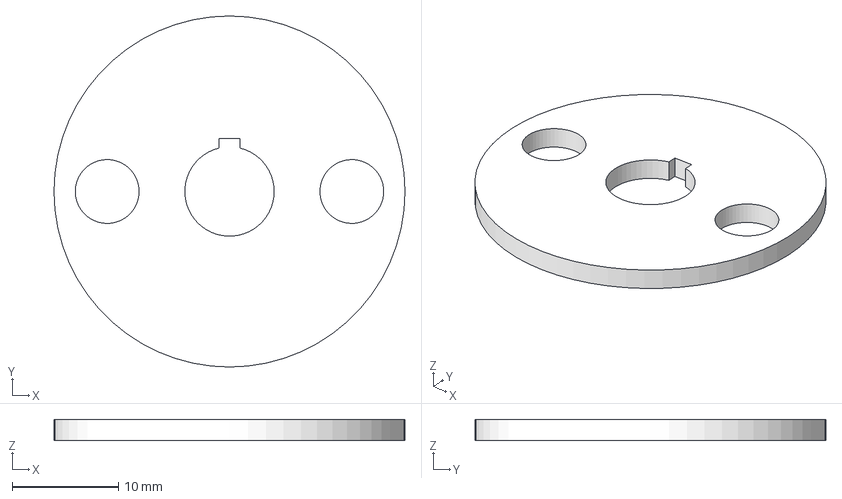
[picture p38: CAD file, 2026-06-04]
SatNOGS_Rotator/rotator_parts/C1071-1_dc_motor_cover.fcstd
33.0 x 33.0 x 2.00 mm
