4111Spyglass/SatNOGS/SatNOGS_Controller/lsf-kicad-lib-master/3d_sources/CONMCX001.FCStd

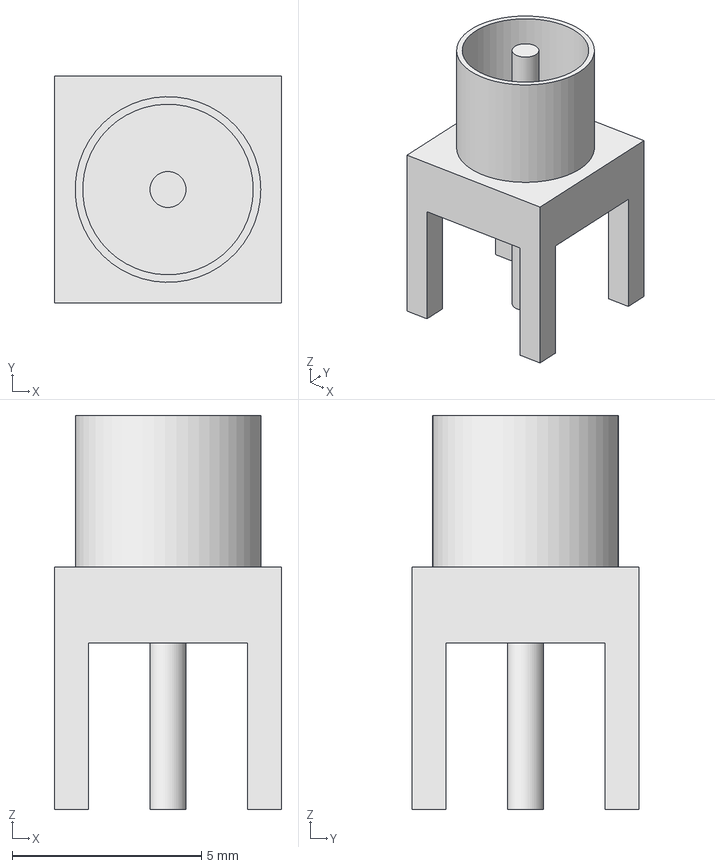
[picture p39: CAD file, 2026-06-04]
SatNOGS_Controller/lsf-kicad-lib-master/3d_sources/CONMCX001.FCStd
6.00 x 6.00 x 10.4 mm
