4111Spyglass/SatNOGS/SatNOGS_Rotator/rotator_parts/C1050-5.fcstd

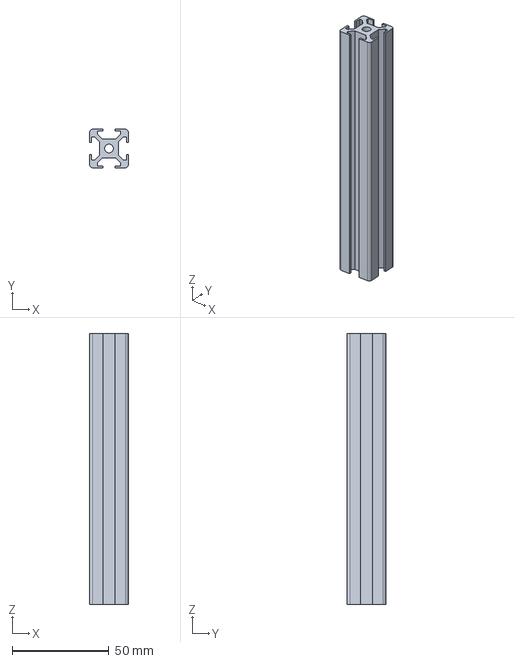
[picture p40: CAD file, 2026-06-04]
SatNOGS_Rotator/rotator_parts/C1050-5.fcstd
20.0 x 20.0 x 140.0 mm
