4111Spyglass/SatNOGS/SatNOGS_Rotator/rotator_parts/C1083-1_shaft_seal.fcstd

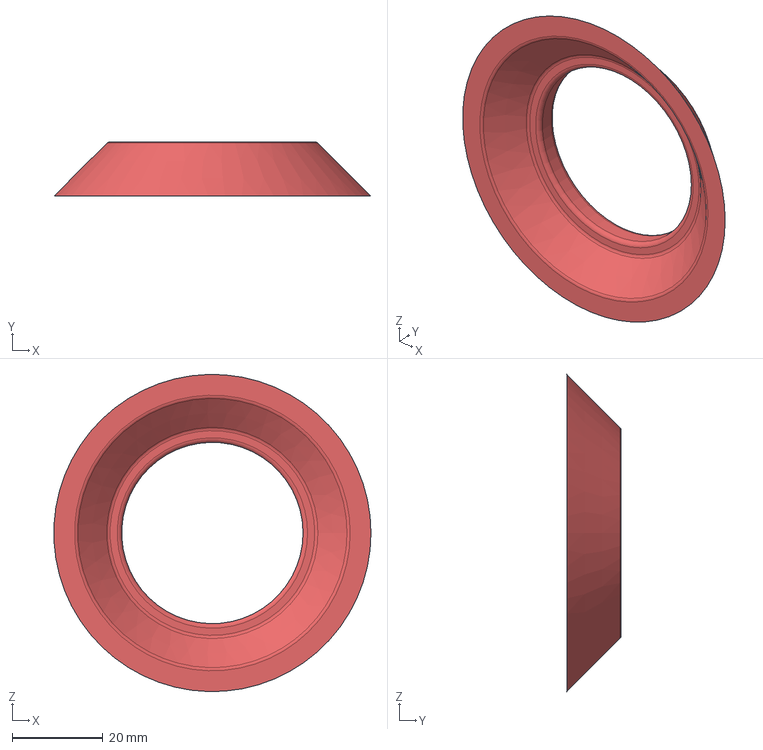
[picture p41: CAD file, 2026-06-04]
SatNOGS_Rotator/rotator_parts/C1083-1_shaft_seal.fcstd
70.0 x 12.0 x 70.0 mm
