4111Spyglass/SatNOGS/SatNOGS_Rotator/rotator_parts/C1072-1_dc_motor_cover.fcstd

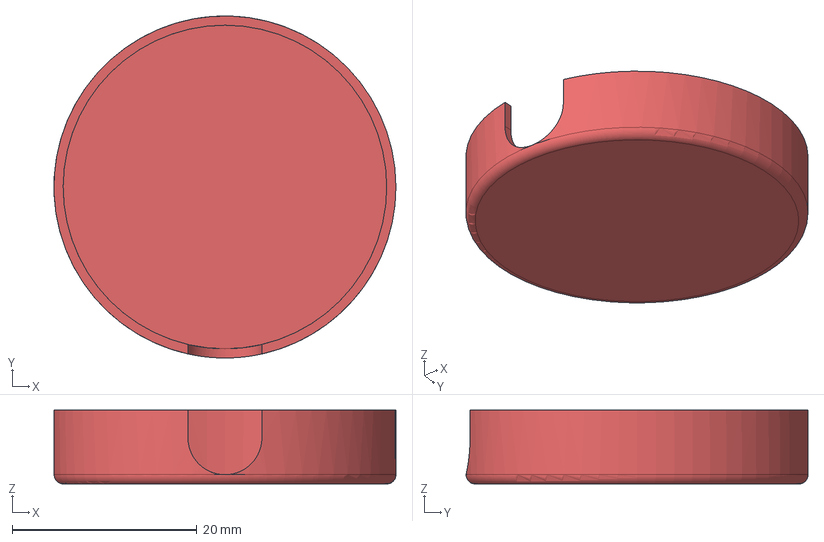
[picture p42: CAD file, 2026-06-04]
SatNOGS_Rotator/rotator_parts/C1072-1_dc_motor_cover.fcstd
37.0 x 37.0 x 8.00 mm
