4111Spyglass/SatNOGS/SatNOGS_Rotator/rotator_parts/C1061-4.fcstd

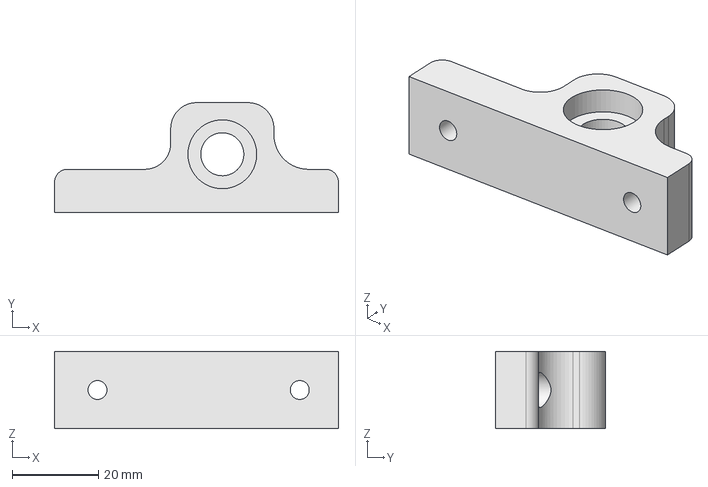
[picture p43: CAD file, 2026-06-04]
SatNOGS_Rotator/rotator_parts/C1061-4.fcstd
66.0 x 25.5 x 18.0 mm
