4111Spyglass/SatNOGS/SatNOGS_Rotator/rotator_parts/C1060-1_worm_shaft.fcstd

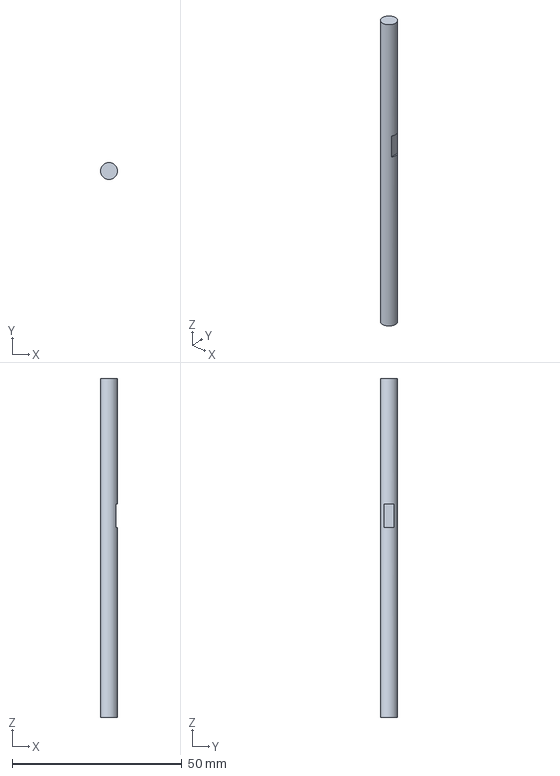
[picture p44: CAD file, 2026-06-04]
SatNOGS_Rotator/rotator_parts/C1060-1_worm_shaft.fcstd
5.00 x 5.00 x 100.0 mm
