4111Spyglass/SatNOGS/SatNOGS_Rotator/rotator_parts/C1062-1_worm_gear.fcstd

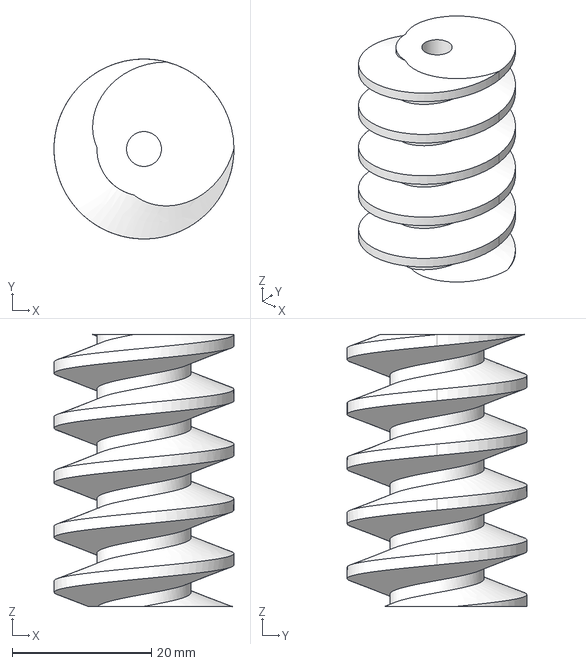
[picture p45: CAD file, 2026-06-04]
SatNOGS_Rotator/rotator_parts/C1062-1_worm_gear.fcstd
25.8 x 25.8 x 39.0 mm
