4111Spyglass/SatNOGS/SatNOGS_Rotator/rotator_parts/C1030-1_motor_mount.fcstd

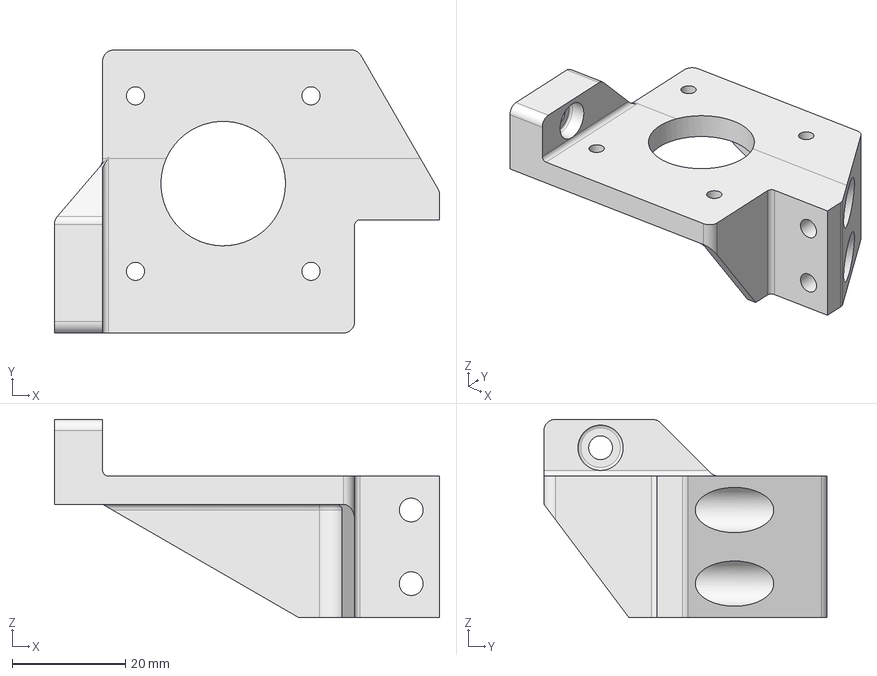
[picture p46: CAD file, 2026-06-04]
SatNOGS_Rotator/rotator_parts/C1030-1_motor_mount.fcstd
68.0 x 50.0 x 35.0 mm
