4111Spyglass/SatNOGS/SatNOGS_Rotator/rotator_parts/C1001-1_symmetric_tube.fcstd

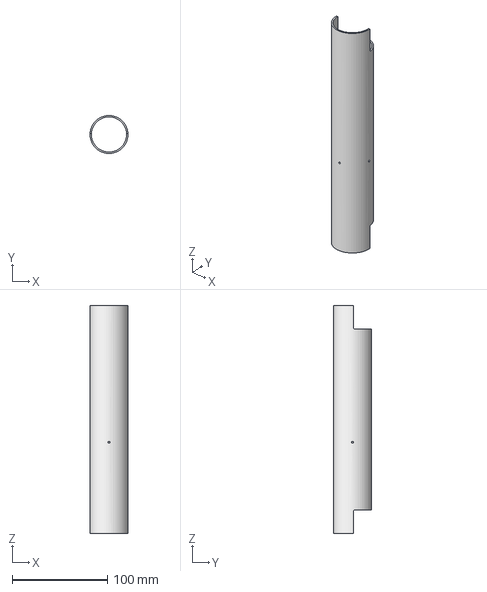
[picture p47: CAD file, 2026-06-04]
SatNOGS_Rotator/rotator_parts/C1001-1_symmetric_tube.fcstd
40.0 x 40.0 x 240.0 mm
