4111Spyglass/SatNOGS/(list of files, cad)

Other CAD files:
SatNOGS_Controller/lsf-kicad-lib-master/3d_sources/MQ-135.FCStd
SatNOGS_Controller/lsf-kicad-lib-master/3d_sources/D2F-L2-A.FCStd
SatNOGS_Controller/lsf-kicad-lib-master/3d_sources/MQ-131.FCStd
SatNOGS_Rotator/rotator_parts/C1082-1_cover_side.fcstd
SatNOGS_Rotator/rotator_parts/C1061-3.fcstd
SatNOGS_Controller/lsf-kicad-lib-master/3d/TPS63080.stp
SatNOGS_Encoder/encoder_parts/C1010-1_encoder_case.3mf
SatNOGS_Encoder/encoder_parts/C1010-1_encoder_case.stl
SatNOGS_Encoder/encoder_parts/C1011-1_encoder_case.3mf
SatNOGS_Encoder/encoder_parts/C1011-1_encoder_case.stl
SatNOGS_Encoder/encoder_parts/C1012-1_magnet_mount.3mf
SatNOGS_Encoder/encoder_parts/C1012-1_magnet_mount.stl
SatNOGS_Encoder/encoder_parts/C1013-1_encoder_gear-Body.stl
SatNOGS_Rotator/rotator_parts/C1001-1_symmetric_tube.3mf
SatNOGS_Rotator/rotator_parts/C1001-1_symmetric_tube.stl
SatNOGS_Rotator/rotator_parts/C1001-3_asymmetric_tube.3mf
SatNOGS_Rotator/rotator_parts/C1001-3_asymmetric_tube.stl
SatNOGS_Rotator/rotator_parts/C1010-3.3mf
SatNOGS_Rotator/rotator_parts/C1010-3.stl
SatNOGS_Rotator/rotator_parts/C1011-3.3mf
SatNOGS_Rotator/rotator_parts/C1011-3.stl
SatNOGS_Rotator/rotator_parts/C1020-1_shaft_gear.3mf
SatNOGS_Rotator/rotator_parts/C1020-1_shaft_gear.stl
SatNOGS_Rotator/rotator_parts/C1021-1_shaft_collar.3mf
SatNOGS_Rotator/rotator_parts/C1021-1_shaft_collar.stl
SatNOGS_Rotator/rotator_parts/C1022-3.3mf
SatNOGS_Rotator/rotator_parts/C1022-3.stl
SatNOGS_Rotator/rotator_parts/C1030-1_motor_mount.3mf
SatNOGS_Rotator/rotator_parts/C1030-1_motor_mount.stl
SatNOGS_Rotator/rotator_parts/C1040-1_encoder_gear.stl
SatNOGS_Rotator/rotator_parts/C1041-1_homing_pin.3mf
SatNOGS_Rotator/rotator_parts/C1041-1_homing_pin.stl
SatNOGS_Rotator/rotator_parts/C1042-1_endstop_mount.3mf
SatNOGS_Rotator/rotator_parts/C1042-1_endstop_mount.stl
SatNOGS_Rotator/rotator_parts/C1043-1_encoder_mount.3mf
SatNOGS_Rotator/rotator_parts/C1043-1_encoder_mount.stl
SatNOGS_Rotator/rotator_parts/C1050-1_tslot6_100.3mf
SatNOGS_Rotator/rotator_parts/C1050-1_tslot6_100.stl
SatNOGS_Rotator/rotator_parts/C1050-5.3mf
SatNOGS_Rotator/rotator_parts/C1050-5.stl
SatNOGS_Rotator/rotator_parts/C1060-1_worm_shaft.3mf
SatNOGS_Rotator/rotator_parts/C1060-1_worm_shaft.stl
SatNOGS_Rotator/rotator_parts/C1061-3.3mf
SatNOGS_Rotator/rotator_parts/C1061-3.stl
SatNOGS_Rotator/rotator_parts/C1061-4.3mf
SatNOGS_Rotator/rotator_parts/C1061-4.stl
SatNOGS_Rotator/rotator_parts/C1062-1_worm_gear.3mf
SatNOGS_Rotator/rotator_parts/C1062-1_worm_gear.stl
SatNOGS_Rotator/rotator_parts/C1070-1_dc_motor_adapter.3mf
SatNOGS_Rotator/rotator_parts/C1070-1_dc_motor_adapter.stl
SatNOGS_Rotator/rotator_parts/C1071-1_dc_motor_cover.3mf
SatNOGS_Rotator/rotator_parts/C1071-1_dc_motor_cover.stl
SatNOGS_Rotator/rotator_parts/C1072-1_dc_motor_cover.3mf
SatNOGS_Rotator/rotator_parts/C1072-1_dc_motor_cover.stl
SatNOGS_Rotator/rotator_parts/C1080-1_cover_bottom.3mf
SatNOGS_Rotator/rotator_parts/C1080-1_cover_bottom.stl
SatNOGS_Rotator/rotator_parts/C1081-1_cover_top.3mf
SatNOGS_Rotator/rotator_parts/C1081-1_cover_top.stl
SatNOGS_Rotator/rotator_parts/C1082-1_cover_side.3mf
SatNOGS_Rotator/rotator_parts/C1082-1_cover_side.stl
SatNOGS_Rotator/rotator_parts/C1082-3_cover_side.3mf
SatNOGS_Rotator/rotator_parts/C1082-3_cover_side.stl
SatNOGS_Rotator/rotator_parts/C1083-1_shaft_seal.3mf
SatNOGS_Rotator/rotator_parts/C1083-1_shaft_seal.stl
