4111Spyglass/SatNOGS/SatNOGS_Encoder/kicad/SatNOGS_Encoder.kicad_pcb

## KiCad design SatNOGS_Encoder/kicad/SatNOGS_Encoder.kicad_pcb (2026-06-04)

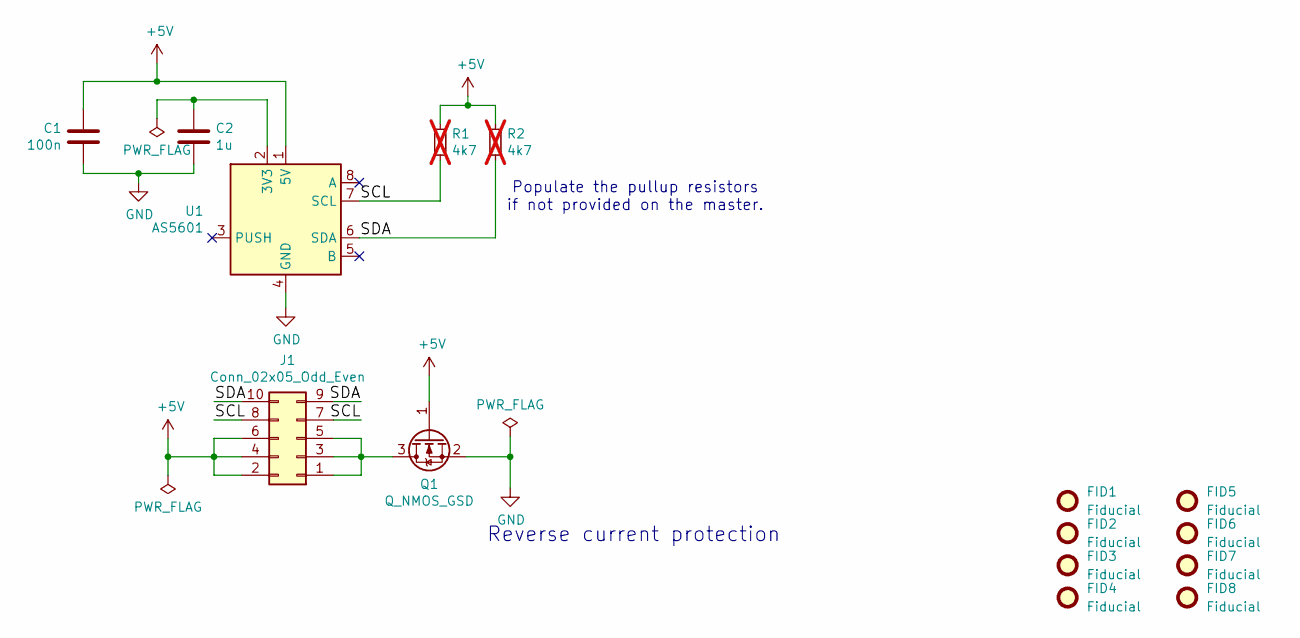
[picture p48: schematic SatNOGS_Encoder.kicad_sch, AS5601 - Encoder]

Parts:
C1: 100n; C_0805_2012Metric_Pad1.18x1.45mm_HandSolder; Part Number CC0805KRX7R9BB104
C2: 1u; C_0805_2012Metric_Pad1.18x1.45mm_HandSolder; Part Number CC0805KKX7R7BB105
FID1, FID2, FID3, FID4, FID5, FID6, FID7, FID8: Fiducial; Fiducial_1mm_Mask2mm
J1: Conn_02x05_Odd_Even; PinHeader_2x05_P2.54mm_Vertical; Part Number 67997-410HLF
Q1: Q_NMOS_GSD; SOT-23_Handsoldering; Part Number SI2312CDS-T1-GE3
R1, R2: 4k7; R_0805_2012Metric_Pad1.20x1.40mm_HandSolder; Part Number RC0805FR-074K7L; not fitted
U1: AS5601; SOIC-8_3.9x4.9mm_P1.27mm; Part Number AS5601-ASOM

Connections:
+5V: C1.2, J1.2, J1.4, J1.6, Q1.1 (G), R1.2, R2.2, U1.1 (5V)
/SCL: J1.7, J1.8, R1.1, U1.7 (SCL)
/SDA: J1.9, J1.10, R2.1, U1.6 (SDA)
GND: C1.1, C2.2, Q1.2 (S), U1.4 (GND)
unnamed: J1.1, J1.3, J1.5, Q1.3 (D)
unnamed: C2.1, U1.2 (3V3)

Notes on the sheet:
Reverse current protection
Populate the pullup resistors if not provided on the master.

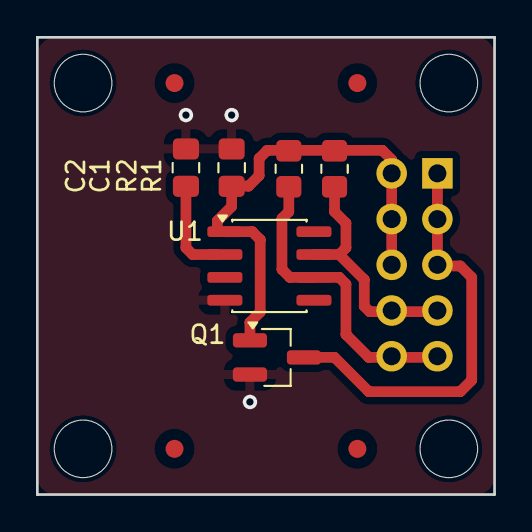
[picture p49: board SatNOGS_Encoder.kicad_pcb from above]

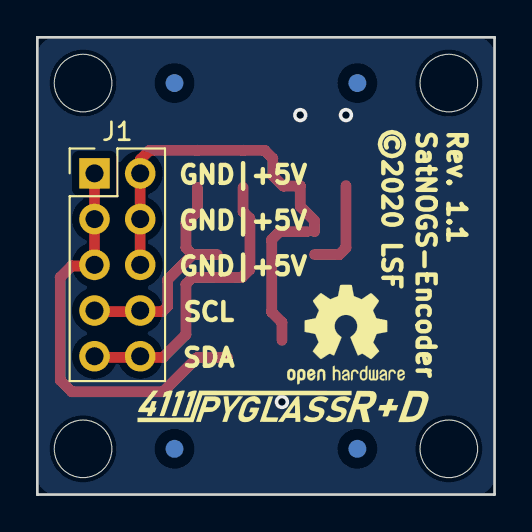
[picture p50: board SatNOGS_Encoder.kicad_pcb from below]

Board: 2 copper layers, 25.4 x 25.4 mm, 20 parts (6 on the bottom side), 6 nets.

Other parts of the board:
H1, H2, H3, H4: MountingHole; MountingHole_3.2mm_M3
©2020 LSF: SatNOGS-Encoder; OSHW-Logo2_7.3x6mm_SilkScreen
