4111Spyglass/SatNOGS/SatNOGS_Controller/SatNOGS_Controller.kicad_pcb

## KiCad design SatNOGS_Controller/SatNOGS_Controller.kicad_pcb (2026-06-04)

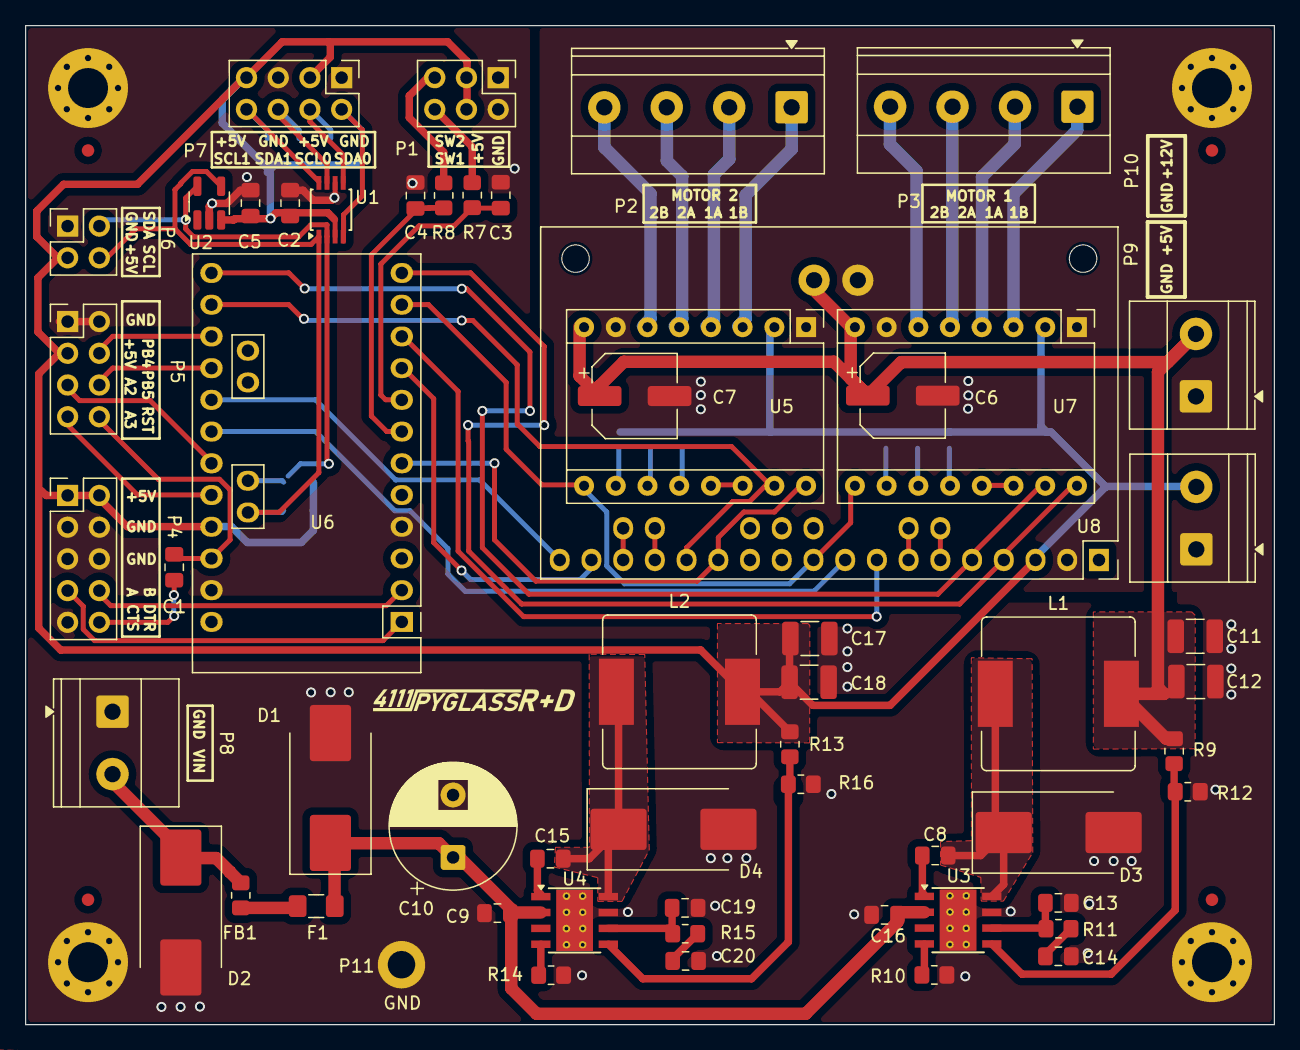
[picture p51: board SatNOGS_Controller.kicad_pcb from above]

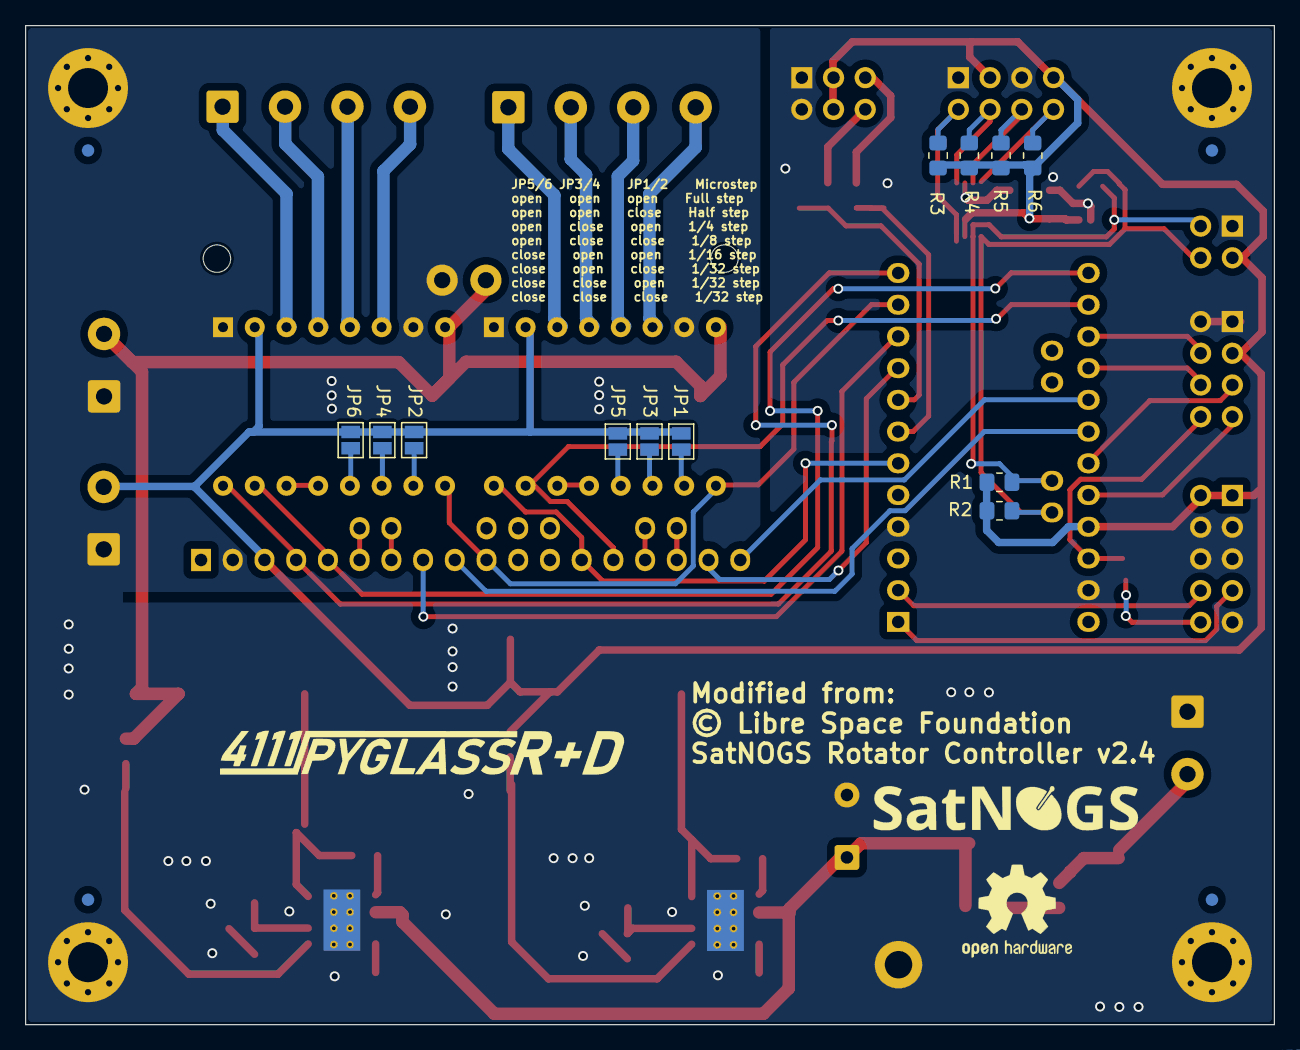
[picture p52: board SatNOGS_Controller.kicad_pcb from below]

Board: 2 copper layers, 100.0 x 80.0 mm, 81 parts (16 on the bottom side), 65 nets.

Parts:
C1, C2, C3, C4, C5, C8, C15: 100n; C_0805_2012Metric_Pad1.18x1.45mm_HandSolder
C6, C7: 100u; CP_Elec_6.3x5.3
C9, C16: 2u2; C_0805_2012Metric_Pad1.18x1.45mm_HandSolder
C10: 100u; CP_Radial_D10.0mm_P5.00mm
C11, C12, C17, C18: 47u; C_1210_3225Metric_Pad1.33x2.70mm_HandSolder
C13: 10p; C_0805_2012Metric_Pad1.18x1.45mm_HandSolder
C14: 7n5; C_0805_2012Metric_Pad1.18x1.45mm_HandSolder
C19: 39p; C_0805_2012Metric_Pad1.18x1.45mm_HandSolder
C20: 6n8; C_0805_2012Metric_Pad1.18x1.45mm_HandSolder
D1, D3, D4: D_Schottky; D_SMC_Handsoldering
D2: D_TVS; D_SMC_Handsoldering
F1: Fuse; Fuse_1206_3216Metric_Pad1.42x1.75mm_HandSolder
FB1: 220R; R_0805_2012Metric_Pad1.20x1.40mm_HandSolder
FID1, FID2, FID3, FID4, FID5, FID6, FID7, FID8: Fiducial; Fiducial_1mm_Mask2mm
H1, H2, H3, H4: MountingHole_Pad; MountingHole_3.2mm_M3_Pad_Via
JP1, JP2, JP3, JP4, JP5, JP6: SolderJumper-2_P1.3mm_Open_Pad1.0x1.5mm
L1: 27u; L_Bourns_SRR1210A
L2: 8u2; L_Bourns_SRR1210A
P1: PinHeader_2x03_P2.54mm_Vertical
P2, P3: TerminalBlock_Phoenix_MKDS-1,5-4_1x04_P5.00mm_Horizontal
P4: PinHeader_2x05_P2.54mm_Vertical
P5, P7: PinHeader_2x04_P2.54mm_Vertical
P6: PinHeader_2x02_P2.54mm_Vertical
P8, P9, P10: TerminalBlock_Phoenix_MKDS-1,5-2_1x02_P5.00mm_Horizontal
P11: MountingHole_2.2mm_M2_DIN965_Pad
R1, R2, R3, R4, R5, R6: 4K7; R_0805_2012Metric_Pad1.20x1.40mm_HandSolder
R7, R8: 200; R_0805_2012Metric_Pad1.20x1.40mm_HandSolder
R9: 142K8; R_0805_2012Metric_Pad1.20x1.40mm_HandSolder
R10: 221K; R_0805_2012Metric_Pad1.20x1.40mm_HandSolder
R11: 26K7; R_0805_2012Metric_Pad1.20x1.40mm_HandSolder
R12, R16: 10K2; R_0805_2012Metric_Pad1.20x1.40mm_HandSolder
R13: 53K6; R_0805_2012Metric_Pad1.20x1.40mm_HandSolder
R14: 162K; R_0805_2012Metric_Pad1.20x1.40mm_HandSolder
R15: 13K; R_0805_2012Metric_Pad1.20x1.40mm_HandSolder
U1: PCA9540B; TSSOP-8_3x3mm_P0.65mm
U2: TC74; SOT-23-5_HandSoldering
U3, U4: TPS54360DDA; Texas_HSOP-8-1EP_3.9x4.9mm_P1.27mm_ThermalVias
U5, U7: Pololu_Breakout_A4988; Pololu_Breakout-16_15.2x20.3mm
U6: Arduino_Pro_Mini_328
U8: Pololu_Dual_MC33926

Connections:
+5V: C2.2, C5.1, C17.1, C18.1, JP1.1 (A), JP2.2 (B), JP3.1 (A), JP4.2 (B), JP5.1 (A), JP6.2 (B), L2.2, P1.3, P1.4, P4.1, P4.2, P5.3, P6.3, P7.3, P7.7, P9.2, R1.1, R2.1, R3.1, R4.1, R5.1, R6.1, R13.1, U1.3 (VDD), U2.3 (VDD), U5.2 (VDD), U6.25 (VCC), U7.2 (VDD), U8.3 (VDD)
+12V: C6.1, C7.1, C11.1, C12.1, L1.2, P10.2, R9.1, U5.8 (VMOT), U7.8 (VMOT), U8.26 (VMOT)
/1AM1: P3.2, U7.4 (1A)
/1AM2: P2.2, U5.4 (1A)
/1BM1: P3.1, U7.3 (1B)
/1BM2: P2.1, U5.3 (1B)
/2AM1: P3.3, U7.5 (2A)
/2AM2: P2.3, U5.5 (2A)
/2BM1: P3.4, U7.6 (2B)
/2BM2: P2.4, U5.6 (2B)
/A: P4.7, U6.1 (PD1/TX)
/A2: P5.5, U6.21 (PC2/A2)
/A3: P5.7, U6.22 (PC3/A3)
/B: P4.8, U6.2 (PD0/RX)
/DTR: C1.2, P4.10
/EN: U5.9 (~ENABLE), U6.11 (PB0/8), U7.9 (~ENABLE), U8.10 (EN)
/M1D1: U8.7 (M1D1), U8.24 (GND)
/M1D2: U8.6 (M1D2), U8.25 (VDD-OUT)
/M1FB: U6.20 (PC1/A1), U8.9 (M1FB)
/M1IN1: U6.13 (PB2/10), U7.15 (STEP), U8.5 (M1IN1)
/M1IN2: U6.12 (PB1/9), U7.16 (DIR), U8.4 (M1IN2)
/M1RST: U7.13 (~RESET), U7.14 (~SLEEP)
/M1SF: U6.10 (PD7/7), U8.8 (M1SF)
/M2D1: U8.16 (M2D1), U8.19 (GND)
/M2D2: U8.15 (M2D2), U8.20 (VDD-OUT)
/M2FB: U6.19 (PC0/A0), U8.18 (M2FB)
/M2IN1: U5.15 (STEP), U6.14 (PB3/11), U8.14 (M2IN1)
/M2IN2: U5.16 (DIR), U6.6 (PD3/3), U8.13 (M2IN2)
/M2RST: U5.13 (~RESET), U5.14 (~SLEEP)
/M2SF: U6.9 (PD6/6), U8.17 (M2SF)
/MS1M1: JP2.1 (A), U7.10 (MS1)
/MS1M2: JP1.2 (B), U5.10 (MS1)
/MS2M1: JP4.1 (A), U7.11 (MS2)
/MS2M2: JP3.2 (B), U5.11 (MS2)
/MS3M1: JP6.1 (A), U7.12 (MS3)
/MS3M2: JP5.2 (B), U5.12 (MS3)
/PB4: P5.4, U6.15 (PB4/12)
/PB5: P5.6, U6.16 (PB5/13)
/Power/FB5: R13.2, R16.1, U4.5 (FB)
/Power/FB12: R9.2, R12.1, U3.5 (FB)
/Power/SW_VIN: C9.1, C10.1, C16.1, D1.1 (K), F1.1, U3.2 (VIN), U4.2 (VIN)
/RST: C1.1, P5.8, U6.26 (PC6/RST)
/SCL: P6.4, R2.2, U1.1 (SCL), U2.4 (SCLK), U6.24 (PC5/A5)
/SCL0: P7.4, R4.2, U1.5 (SC0)
/SCL1: P7.8, R6.2, U1.8 (SC1)
/SDA: P6.2, R1.2, U1.2 (SDA), U2.5 (SDA), U6.23 (PC4/A4)
/SDA0: P7.2, R3.2, U1.4 (SD0)
/SDA1: P7.6, R5.2, U1.7 (SD1)
/SW1: C3.2, R7.1, U6.8 (PD5/5)
/SW2: C4.1, R8.2, U6.7 (PD4/4)
/VIN: D2.1 (A1), FB1.2, P8.2
GND: C2.1, C3.1, C4.2, C5.2, C6.2, C7.2, C9.2, C10.2, C11.2, C12.2, C13.2, C14.2, C16.2, C17.2, C18.2, C19.2, C20.2, D1.2 (A), D2.2 (A2), D3.2 (A), D4.2 (A), H1.1, H2.1, H3.1, H4.1, P1.1, P1.2, P4.3, P4.4, P4.5, P4.6, P4.9, P5.1, P5.2, P6.1, P7.1, P7.5, P8.1, P9.1, P10.1, P11.1, R10.2, R12.2, R14.2, R16.2, U1.6 (VSS), U2.2 (GND), U3.7 (GND), U3.9 (GNDPAD), U4.7 (GND), U4.9 (GNDPAD), U5.1 (GND), U5.7 (GND), U6.4 (GND), U6.27 (GND), U7.1 (GND), U7.7 (GND), U8.2 (GND), U8.27 (GND)
unnamed: C14.1, R11.2
unnamed: C20.1, R15.2
unnamed: C8.2, D3.1 (K), L1.1, U3.8 (SW)
unnamed: C15.2, D4.1 (K), L2.1, U4.8 (SW)
unnamed: F1.2, FB1.1
unnamed: P1.5, R8.1
unnamed: P1.6, R7.2
unnamed: C8.1, U3.1 (BOOT)
unnamed: C13.1, R11.1, U3.6 (COMP)
unnamed: R10.1, U3.4 (RT/CLK)
unnamed: C15.1, U4.1 (BOOT)
unnamed: C19.1, R15.1, U4.6 (COMP)
unnamed: R14.1, U4.4 (RT/CLK)
