4111Spyglass/SatNOGS/(commit log)

2026-06-04 upload my versions of SatNOGS controller and encoder
    [ATB2012.FCStd, CONMCX001.FCStd, D2F-L.FCStd, D2F-L2-A.FCStd, D2F-L2-A1.FCStd, DF11-10DP-2DS.FCStd, KEYSTONE-1502-2.FCStd, KEYSTONE-7698.FCStd]
2026-06-04 SatNOGS Rotator: parts from v3.1 in step and 3mf formats
    [C1001-1_symmetric_tube.3mf, C1001-1_symmetric_tube.fcstd, C1001-1_symmetric_tube.stl, C1001-3_asymmetric_tube.3mf, C1001-3_asymmetric_tube.fcstd, C1001-3_asymmetric_tube.stl, C1010-3.3mf, C1010-3.fcstd]
2026-06-04 convert encoder fcstd to 3mf and stl
    [A1010-1_as5601_encoder.fcstd, C1010-1_encoder_case.3mf, C1010-1_encoder_case.fcstd, C1010-1_encoder_case.stl, C1011-1_encoder_case.3mf, C1011-1_encoder_case.fcstd, C1011-1_encoder_case.stl, C1012-1_magnet_mount.3mf]
2026-06-05 BOMs with links to Amazon, AliExpress, and McMaster
    [part-number-list.xlsx, rotator-bom.xlsx, satnogs-rotator-controller-encoder-bom.xlsx]
