4111Spyglass/SatNOGS/(notices)

Notices in the files:
SatNOGS_Controller/SatNOGS_Controller.kicad_pcb:
Modified from:
© Libre Space Foundation
